YLexi/YL/Курсач.docx

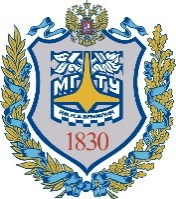
[picture p1: figure]
Gerb-BMSTU_01

| Министерство науки и высшего образования Российской Федерации Федеральное государственное бюджетное образовательное учреждение высшего образования «Московский государственный технический университет имени Н.Э. Баумана (национальный исследовательский университет)» (МГТУ им. Н.Э. Баумана)

ФАКУЛЬТЕТ _________РЛ__________________________________________________________

КАФЕДРА ___________РЛ-1___________________________________________________________

РАСЧЕТНО-ПОЯСНИТЕЛЬНАЯ ЗАПИСКА

К КУРСОВОМУ ПРОЕКТУ

НА ТЕМУ:

Зеркальная антенна для абонентского терминала системы спутниковой связи ________________________________ _______________________________________________

_______________________________________________

_______________________________________________

_______________________________________________

_______________________________________________

_______________________________________________

Студент РЛ1-61_________ _________________ Саломатин А.Д.______

(Группа) (Подпись, дата) (И.О.Фамилия)

Руководитель курсового проекта _________________ __В.А. Вечтомов_____

(Подпись, дата) (И.О.Фамилия)

Консультант _________________ ____________________

(Подпись, дата) (И.О.Фамилия)

2021 г.

Министерство науки и высшего образования Российской Федерации

Федеральное государственное бюджетное образовательное учреждение

высшего образования

«Московский государственный технический университет имени Н.Э. Баумана

(национальный исследовательский университет)»

(МГТУ им. Н.Э. Баумана)

УТВЕРЖДАЮ

Заведующий кафедрой __________

(Индекс)

______________ _______________

(И.О.Фамилия)

« _____ » ____________ 20 ____ г.

ЗАДАНИЕ

на выполнение курсового проекта

по дисциплине ____Устройства СВЧ и антенны____________________________________

Студент группы _РЛ1-61_________

______________________Саломатин Алексей Дмитриевич___________________________

(Фамилия, имя, отчество)

Тема курсового проекта:

Зеркальная антенна для абонентского терминала системы спутниковой связи

Направленность КП (учебный, исследовательский, практический, производственный, др.)

________________________________________________________________________________

Источник тематики (кафедра, предприятие, НИР) _____________________________________

График выполнения проекта: 25% к ___ нед., 50% к ___ нед., 75% к __ нед., 100% к ___ нед.

Задание: Разработать на уровне технического предложения приемо-передающую антенну типа Кассегрена или АДЭ приема для системы спутниковой связи (земная станция или абонентский терминал). Антенна должна удовлетворять следующим основным требованиям:

- рабочая частота на прием: 14,05…14,75 ГГц;
- коэффициент усиления не менее 48,5 дБ;
- поляризация принимаемых сигналов – на прием и передачу линейные, ортогональные;
- уровень боковых лепестков не выше -22 дБ.
- Рабочая частота на передачу: 11,25…11,95 ГГц

Оформление курсового проекта:

Расчетно-пояснительная записка на _____ листах формата А4.

Перечень графического (иллюстративного) материала (чертежи, плакаты, слайды и т.п.)

_______________________________________________________________________________

_______________________________________________________________________________

_______________________________________________________________________________

_______________________________________________________________________________

Дата выдачи задания « 24 » февраля 2021 г.

Руководитель курсового проекта _________________ В.А. Вечтомов_____

(Подпись, дата) (И.О.Фамилия)

Студент _________________ _А.Д. Саломатин_____

(Подпись, дата) (И.О.Фамилия)

Примечание: Задание оформляется в двух экземплярах: один выдается студенту, второй хранится на кафедре.

СОКРАЩЕНИЯ ТЕРМИНОВ, АББРЕВИАТУРЫ

КУ – коэффициент усиления

ТЗ – техническое задание

ДН – диаграмма направленности

КИП - коэффициент использования площади раскрыва антенны

КНД-коэффициент направленного действия

КПД - коэффициент полезного действия

УБЛ – уровень боковых лепестков

# Расчет геометрии антенны

Антенны типа Кассегрена относятся к классу двухзеркальных антенн.

Тогда:

Рабочую частоту примем равной середине диапазона, заданного в условии:

f=(14,75+14,05)/2=14,4 ГГц

Рабочая длинна волны:

λ=c/f=(3∙10^8)/(14,4∙10^9)≈20,83 мм,

где с-скорость света в вакууме.

Для нашей антенны справедливо следующее [1]:

G=9,96+20lg((D_0)/λ)+⁡k_(исп)

где G - коэффициент усиления (КУ) (по заданию равен 48,5 дБ)

D0 - диаметр большого зеркала

kисп – коэффициент использования поверхности раскрыва, примем его за -3 дБ

В итоге получим следующее:

D_0 =λ∙10^((G-9.96-k_(исп))/20) ≈1,246 м

Так как величина диаметра должна быть стандартизованной, то:

D_0 =1,3 м=1300 мм

Проверим выполнение условий ТЗ для этого диаметра, коэффициент усиления:

9,96+20lg(1300/(20,83))-3≈44.669 дБ

Данное значение очень близко к граничному и при погрешности измерительных приборов в 0.5 дБ КУ не будет удовлетворять заданному в ТЗ, поэтому увеличим диаметр большого зеркала до 1700 мм, тогда КУ:

9,96+20lg(1700/(20,83))-3≈45.195 дБ

Получившийся КУ превышает требуемый на 0.695 дБ, что гарантирует выполнение требований ТЗ. Таким образом:

D_0 =1,7 м=1700 мм

Так как гиперболоид софокусен параболоиду, мы можем получить остальные параметры кривых обоих зеркал. При этом нам необходимо дополнительно задать такие параметры как:

Предельный угол раствора параболы: φ_0 =80°

Угол облучения источником краев малого зеркала: φ_2 =8°

Для схемы Кассегрена справедливы следующие соотношения (f- фокусное расстояние гиперболы, F- фокусное расстояние параболы)

Эксцентриситет гиперболы: e=(sin((φ_0 +φ_2)/2))/(sin((φ_0 -φ_2)/2))≈1.182

Диаметр малого зеркала: d_0 =D_0 ((e-1))/((e+1))∙ctg((φ_0)/2)≈0,169 м=168,836 мм

Фокусное расстояние большого зеркала F=((e+1)∙d_0)/(4∙(e-1))≈0,506 м=506,495 мм

f=(d_0 ∙cos((φ_0 +φ_2)/2))/(4sin((φ_0)/2)∙cos((φ_2)/2))≈0,047351 м=47,351 мм

Расстояние до эквивалентного зеркала:

F_э =F∙(e+1)/(e-1)=6,078 м

Расчет волновода

Так как в задании указан диапазон частот 14,05…14,75 ГГц, то по ГОСТ Р 55774-2013 подходящее сечение прямоугольного волновода составляет 17,00 х 8,00 мм. Проверим, выполняются ли условия распространения для волны H10:

a<λ<2a

17 мм<20,83 мм<34 мм (верно)

2b<λ<2a

16 мм<20,83 мм<34 мм (верно)

Толщина стенок 1.4мм. Таким образом, сечение волновода 17,00 х 8,00 мм подходит для конструкции антенны.

Определение размеров раскрыва рупора

Для облучения будем использовать пирамидальный рупор. Важным условием при выборе рупора является тот факт, что на краях эквивалентного зеркала значение ДН должно отличаться от максимального на -10дБ. Таким образом, мы знаем значение ДН рупора на уровне -10дБ, оно равна φ_2 =8° (угол облучения краев эквивалентного зеркала). Диаграмма направленности рупора в Е-плоскости [2]:

F_E (θ)=(1+cosθ)/2∙(sinu_y)/(u_y)

Диаграмма направленности рупора в Н-плоскости:

F_H (θ)=(π/2)^2 (1+cosθ)/2∙(sinu_x)/((π/2)^2 -u_x)

где u_x и u_y – обобщённые угловые координаты, А, В - размеры рупора:

u_x =(πA)/λsinθ

u_y =(πB)/λsinθ

На краях эквивалентного зеркала должно выполняться следующее условия:

20log_10 ((1+cosφ_2)/2∙(sin(πB)/λsinφ_2)/((πB)/λsinφ_2))=-10

20log_10 ((π/2)^2 (1+cosφ_2)/2∙(sin(πA)/λsinφ_2)/((π/2)^2 -((πA)/λsinφ_2 )^2))=-10

Откуда:

B≈110 мм , А≈152 мм

Длину рупора возьмем равной:

L≈100 мм

Угол раскрыва в Е-плоскости:

α=arctg⁡((A/2-a/2)/L)≈34,206°

Величина фазового набега:

360/λ∙(L/(cos(α))-L)-360≈1,724°

Величина фазового набега меньше 45 градусов

Теперь можем построить ДН рупора в Е-плоскости (рисунок 1):

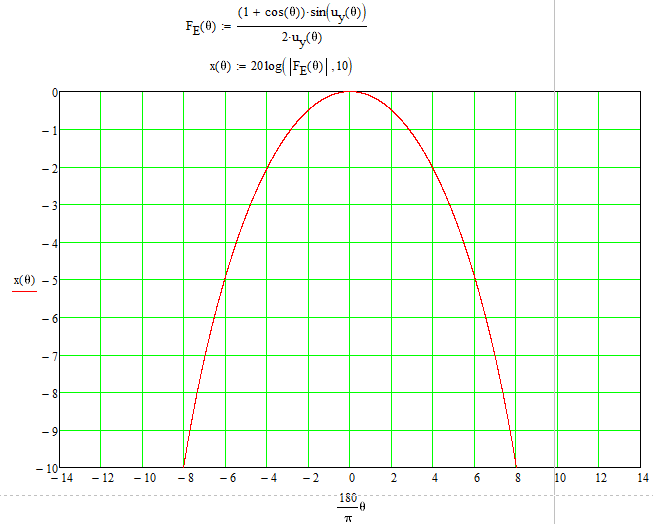
[picture p2: figure]

Рисунок 1

Уровню -10дБ соответствует угол, равный φ_2 =8° . ДН рупора в Н-плоскости имеет такую же форму и значению -10дБ также соответствуют углы в 8 и -8 градусов.

Расчет ДН антенны

С помощью радиуса эквивалентного зеркала (0.8м) и расстояния до него (6.078м) можем рассчитать ДН антенны с помощью подбора функции распределения амплитуд (Рисунок 2):

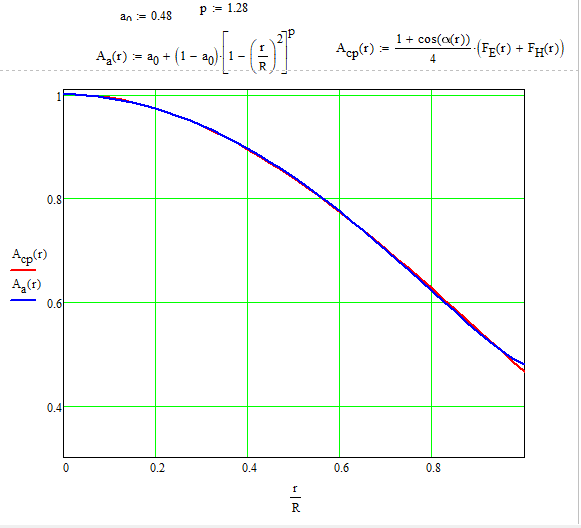
[picture p3: figure]

Рисунок 2

Итоговая ДН антенны построена с помощью функций Бесселя (Рисунок 3):

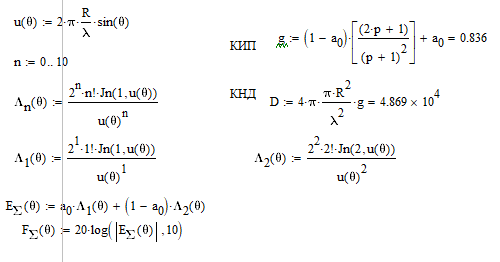
[picture p4: figure]

Рисунок 3

Она имеет следующий вид (Рисунок 4):

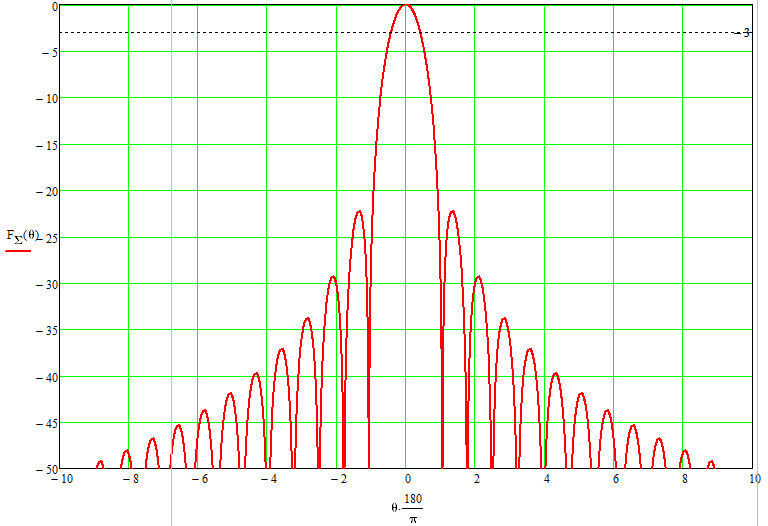
[picture p5: figure]

Рисунок 4

С помощью параметров аппроксимации рассчитаем КИП, КНД, КПД:

ν=(1-a_0 )∙(2p+1)/((p+1)^2)+a_0 =0,836

D=4π(πR^2)/(λ^2)∙ν=4,869∙10^4

Ширина главного лепестка по уровню – 3 дБ:

θ_0.5 =0,848°

Уровень боковых лепестков:

УБЛ=-22,282 дБ

УБЛ не превышает значения -22 дБ, что удовлетворяет требованиям ТЗ.

Описание конструкции волноводного фланца

По ГОСТ 13317-89 (таблица 6, чертеж 31) для прямоугольного волновода сечением 17,00 х 8,00 мм и толщиной стенок 1.4 мм подбираем фланец. Эскиз фланца, построенный в программе Компас-3Д, показан на рисунке 4:

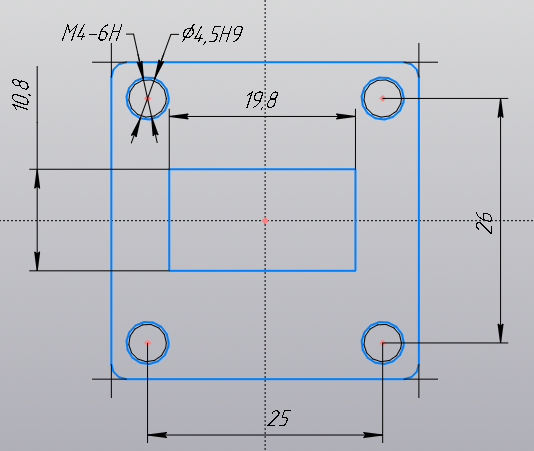
[picture p6: figure]

Рисунок 4

Литературные источники

1) «Антенны УКВ» Под ред. Г.З. Айзенберга. В 2-х ч. Ч.2.М., «Связь», 1977. с.20
2) «Исследование характеристик устройств СВЧ и антенн» В.Л. Хандамиров и др.-Москва : Издательство МГТУ им. Н.Э. Баумана, 2018,с.29.
3) «Антенны УКВ» Под ред. Г.З. Айзенберга. В 2-х ч. Ч.1.М., «Связь», 1977, с.153
