YLexi/YL/РПЗ.docx

Gerb-BMSTU_01

| Министерство науки и высшего образования Российской Федерации Федеральное государственное бюджетное образовательное учреждение высшего образования «Московский государственный технический университет имени Н.Э. Баумана (национальный исследовательский университет)» (МГТУ им. Н.Э. Баумана)

ФАКУЛЬТЕТ _________РЛ__________________________________________________________

КАФЕДРА ___________РЛ-1___________________________________________________________

РАСЧЕТНО-ПОЯСНИТЕЛЬНАЯ ЗАПИСКА

К КУРСОВОМУ ПРОЕКТУ

НА ТЕМУ:

Зеркальная антенна для абонентского терминала системы спутниковой связи___________________________________________

_______________________________________________

_______________________________________________

_______________________________________________

_______________________________________________

_______________________________________________

Студент РЛ1-61_________ _________________ __С.А. Чекановский_

(Группа) (Подпись, дата) (И.О.Фамилия)

Руководитель курсового проекта _________________ __В.А. Вечтомов_____

(Подпись, дата) (И.О.Фамилия)

Консультант _________________ ____________________

(Подпись, дата) (И.О.Фамилия)

2021 г.

Министерство науки и высшего образования Российской Федерации

Федеральное государственное бюджетное образовательное учреждение

высшего образования

«Московский государственный технический университет имени Н.Э. Баумана

(национальный исследовательский университет)»

(МГТУ им. Н.Э. Баумана)

УТВЕРЖДАЮ

Заведующий кафедрой __________

(Индекс)

______________ _______________

(И.О.Фамилия)

« _____ » ____________ 20 ____ г.

ЗАДАНИЕ

на выполнение курсового проекта

по дисциплине ____Устройства СВЧ и антенны____________________________________

Студент группы _РЛ1-61_________

__Чекановский Сергей Александрович____________________________________________

(Фамилия, имя, отчество)

Тема курсового проекта:

Зеркальная антенна для абонентского терминала системы спутниковой связи

Направленность КП (учебный, исследовательский, практический, производственный, др.)

________________________________________________________________________________

Источник тематики (кафедра, предприятие, НИР) _____________________________________

График выполнения проекта: 25% к ___ нед., 50% к ___ нед., 75% к __ нед., 100% к ___ нед.

Задание: Разработать на уровне технического предложения приемо-передающую антенну типа Кассегрена или АДЭ приема для системы спутниковой связи (земная станция или абонентский терминал). Антенна должна удовлетворять следующим основным требованиям:

- рабочая частота на прием: 7,9…8,4 ГГц;
- коэффициент усиления не менее 39 дБ;
- поляризация принимаемых сигналов – на прием и передачу линейные, ортогональные;
- уровень боковых лепестков не выше -22 дБ.
- Рабочая частота на передачу: 7,1…7,7 ГГц

Оформление курсового проекта:

Расчетно-пояснительная записка на _____ листах формата А4.

Перечень графического (иллюстративного) материала (чертежи, плакаты, слайды и т.п.)

_______________________________________________________________________________

_______________________________________________________________________________

_______________________________________________________________________________

_______________________________________________________________________________

Дата выдачи задания « 24 » февраля 2021 г.

Руководитель курсового проекта _________________ В.А. Вечтомов_____

(Подпись, дата) (И.О.Фамилия)

Студент _________________ _С.А. Чекановский_

(Подпись, дата) (И.О.Фамилия)

Примечание: Задание оформляется в двух экземплярах: один выдается студенту, второй хранится на кафедре.

# СОДЕРЖАНИЕ

ПЕРЕЧЕНЬ СОКРАЩЕНИЙ И ОБОЗНАЧЕНИЙ………………………….4

1 Расчёт геометрии антенны………………………………………………….5

2 Расчёт характеристик излучения антенны………………………………...9

2.1 Расчёт облучателя…………………………………………………….9

2.2 Диаграмма направленности антенны……………………………....12

3 Моделирование и конструирование антенны……………………………16

3.1 Большое зеркало……………………………………………………..16

3.2 Фланец для большого зеркала………………………………………17

3.3 Волноводный фланец………………………………………………..18

3.4 Рупор………………………………………………………………….19

3.5 Малое зеркало………………………………………………………..20

3.6 Штанга………………………………………………………………..22

3.7 Крепление штанги…………………………………………………...22

3.8 Проверка коэффициента усиления антенны……………………….23

СПИСОК ИСПОЛЬЗОВАННЫХ ИСТОЧНИКОВ………………………..26

ПЕРЕЧЕНЬ СОКРАЩЕНИЙ И ОБОЗНАЧЕНИЙ

В настоящем отчете о НИР применяют следующие сокращения и обозначения:

ДН – диаграмма направленности

КИП – коэффициент использования поверхности

КНД – коэффициент направленного действия

КПД – коэффициент полезного действия

КУ – коэффициент усиления

ТЗ – техническое задание

УБЛ – уровень боковых лепестков

1 Расчёт геометрии антенны

Схема рассматриваемой двухзеркальной антенны Кассегрена приведена на рисунке 1.

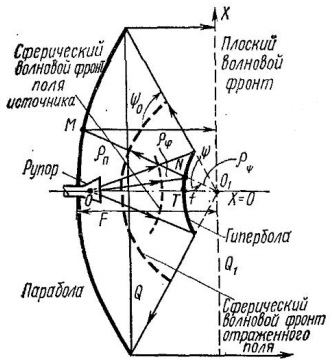
[picture p7: figure]

Рисунок 1 – Схема Кассегрена

Основное зеркало является симметрично усечённым параболоидом вращения с фокусным расстоянием F, вспомогательное зеркало – симметрично усечённым гиперболоидом вращения с фокусным расстоянием f. Гиперболоид софокусен параболоиду в точке O_1 , второй его фокус расположен в точке О.

Перейдём к расчёту геометрии зеркал. Запишем выражение для нахождения коэффициента усиления двухзеркальной антенны:

G=9,96+20lg((D_0)/λ)+10lgk_(исп) ,

где D_0 - диаметр главного зеркала, λ - длина волны, k_(исп) - коэффициент использования поверхности (КИП) двухзеркальной антенны.

Величину k_(исп) примем равной 0,5, подставим значение коэффициента усиления G и найдём отношение D_0 /λ :

9,96+20lg((D_0)/λ)-3=39⇒(D_0)/λ≈43,467.

Для определения рабочей длины волны зададим рабочую частоту f, равную середине заданного в условии диапазона приёма:

f_(пр) =(8,4+7,9)/2=8,15 ГГц.

Тогда

λ=c/f=(3*10^8)/(8,15*10^9)≈0,037 м.

Отсюда

D_0 ≈1,472 м.

Выберем ближайшее значение из стандартного ряда: D_0 =1,600 м.

Определим диаметр вспомогательного зеркала d_0 . Примем

d_0 =8λ=0,294 м.

Зададим ещё два базовых параметра:

- угол раствора образующей параболы: ψ_0 = 96 ⁰;

- угол облучения источником краёв малого зеркала: φ_2 = 25,58⁰.

Теперь на основании этих четырёх параметров можем определить основные геометрические характеристики антенны:

- эксцентриситет гиперболы: e = (sin((ψ_0 +φ_2)/2))/(sin((ψ_0 -φ_2)/2))=(sin((85^⁰ +18^⁰)/2))/(sin((85^⁰ -18^⁰)/2)) ≈ 1,514;

- фокусное расстояние параболического зеркала:

F=0,25D_0 ctg((ψ_0)/2)≈0,36 м;

- фокусное расстояние гиперболического зеркала:

f = (d_0)/4(cos((ψ_0 +φ_2)/2))/(sin((ψ_0)/2)*cos((φ_2)/2)) ≈ 0,05 м;

- расстояние между фокусами гиперболоида:

2C = (d_0)/2(sin(ψ_0 +φ_2 ))/(sin(ψ_0 )*sin(φ_2 )) = 0,292 м;

- расстояние между вершинами гиперболоида:

2a = (d_0)/2(1/(sin(φ_2 ))-1/(sin(ψ_0 ))) ≈ 0,193 м;

- угол облучения источником краёв затенённой области раскрыва:

φ_1 = 2arctg((e-1)/(e+1))^2 ≈ 2,771⁰.

Проведём проверку полученных значений, для чего оценим истинность следующих равенств:

(4F)/(d_0)=(e+1)/(e-1);

(d_0)/(D_0)=(e-1)/(e+1)ctg((ψ_0)/2);

2C=2a+2f;

e=C/a≥1.

Расчёты, произведённые в программе Mathcad 15, подтверждают их истинность (рисунок 2).

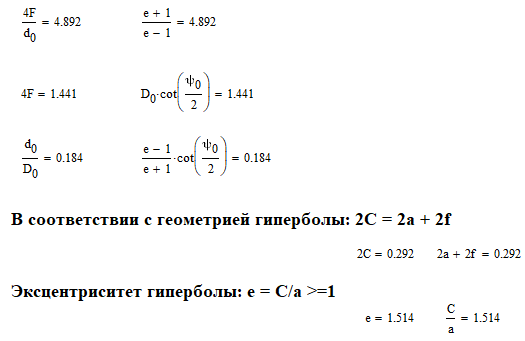
[picture p8: figure]

Рисунок 2 – Проверка расчёта основных геометрических параметров антенны

2 Расчёт диаграммы направленности антенны

2.1 Расчёт облучателя

Для расчёта ДН однозеркальной системы нам необходимо сначала получить ДН облучателя. Выберем в качестве облучателя пирамидальный рупор с прямоугольным раскрывом (рисунок 3).

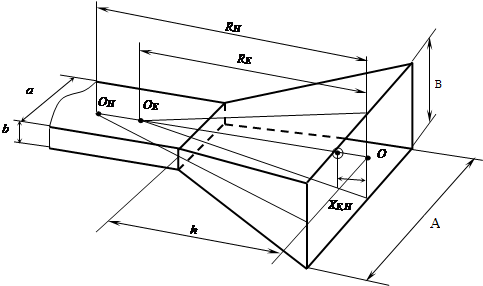
[picture p9: figure]

Рисунок 3 – Геометрия пирамидального рупора

Определим его геометрические размеры, пользуясь выражениями для ДН рупора в двух главных плоскостях симметрии: Е-плоскости и Н-плоскости:

F_E (θ)=(1+cosθ)/2∙(sinu_y)/(u_y);

F_H (θ)=0,15(π)^2 ∙(0,67+cosθ)∙(sinu_x)/((π/2)^2 -u_x),

где u_x и u_y – обобщённые угловые координаты:

u_x =(πA)/λsinθ;

u_y =(πB)/λsin(0,8θ).

Для эффективной работы антенны уровень поля на краях малого зеркала должен равняться приблизительно –10 дБ. Понимая под углом θ угол облучения источником краёв малого зеркала: φ_2 = 25.58⁰, вычислим в программе Mathcad геометрические размеры рупора (рисунок 4).

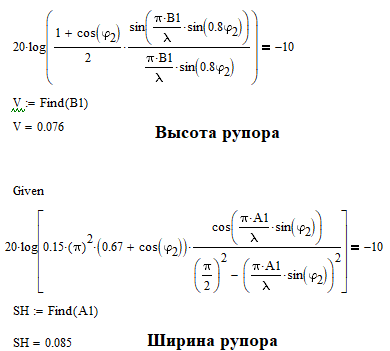
[picture p10: figure]

Рис. 4 – Вычисление размеров апертуры облучателя в программе Mathcad

Таким образом, А = 0,060 м (Н-плоскость), В = 0,088 м (Е-плоскость).

Проверим правильность полученных размеров раскрыва: построим ДН рупора в плоскостях Е и Н (рисунок 5).

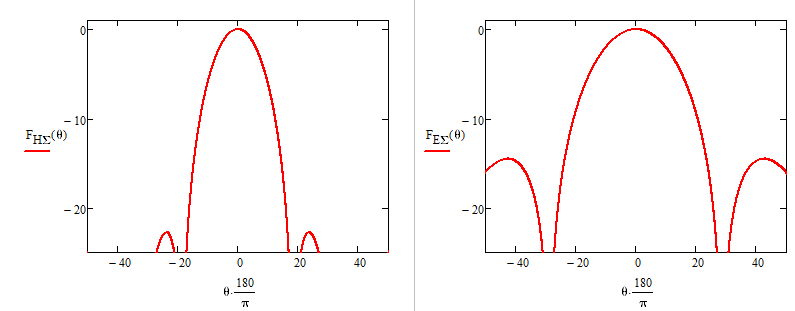
[picture p11: figure]

Рисунок 5 - ДН рупора в плоскостях Е и Н

Как видно из рисунка, значения диаграмм в -10 дБ действительно соответствуют углу φ_2 .

Рассчитаем длину рупора в плоскостях Е и Н (см. рисунок 4). Расстояние в плоскости Е:

R_E =(B^2)/(2λ)=0.079 м;

Расстояние R_H получим из уравнения «стыковки рупора с волноводом»:

R_H (1-a/A)=R_E (1-b/B)⇒R_H =(R_E (1-b/B))/((1-a/A))=0.099 м.

Длина самого рупора (расстояние от центра раскрыва до горловины рупора, одинаковое в плоскостях Е и Н) h можно определить из следующих соотношений:

A/a=(R_H)/(R_H -h)⇒h=0.065 м;

B/b=(R_E)/(R_E -h)⇒h=0.065 м.

Рассчитаем углы раскрыва рупора в обеих плоскостях:

- в плоскости Н:

tgα=(A/2)/(R_H)⇒α=arctg(A/(2R_H))≈23,2^0 ;

- в плоскости E:

tgβ=(B/2)/(R_E)⇒β=arctg(B/(2R_E))≈25,7^0 .

Волна, излучаемая рупором, имеет сферический фронт. Если отклонение фаз на краях рупора не превышает 45⁰, излучающую поверхность считается синфазной. Т.к. углы раскрыва рупора в обеих плоскостях меньше 45⁰, наш рупор «длинный» - фазовыми искажениями можно пренебречь.

2.2 Диаграмма направленности антенны

В приближении геометрической оптики двухзеркальная антенна может быть сведена к эквивалентной ей по распределению поля в раскрыве однозеркальной антенне того же диаметра (рисунок 6).

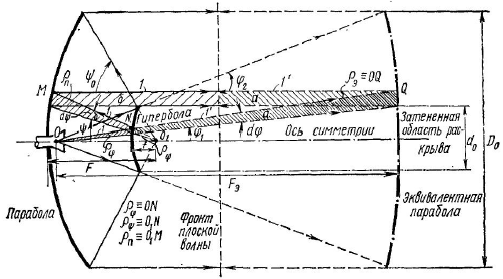
[picture p12: figure]

Рисунок 6 – Эквивалентная схема однозеркальной антенны

Определим фокусное расстояние нового эквивалентного зеркала:

F_Э =F((e+1)/(e-1))≈1,762 м.

Радиус эквивалентного параболоида равен радиусу исходного:

R=(D_0)/2=0,8 м.

Вновь запишем выражения ДН облучателя по приближённым формулам для рупора с малым раскрывом:

- в плоскости вектора электрического поля (плоскость Е):

F_E (α)≈1/2(1+cosα)(sin[(πb)/λsin(0,8α)])/((πb)/λsin(0,8α));

- в плоскости вектора магнитного поля (плоскость H):

F_H (α)≈0,15π^2 (0,67+cosα)(cos((πa)/λsinα))/((π/2)^2 -((πa)/λsinα)^2).

Задаваясь координатами точек на раскрыве зеркала, определим значения α по формуле:

α=arctg[(r/R)/(((F_Э)/R-(r/R)^2 R/(4F)))].

Найдём усреднённое распределение амплитуд поля в раскрыве:

A(r)=(1+cosα)/4[F_E (α)+F_H (α)].

Функция, аппроксимирующая распределение амплитуд:

A^(') (r)=a_0 +(1-a_0 )[1-(r/R)^2 ]^p .

Обеспечим её наименьшее отклонение от усреднённого распределения подбором показателя p и постоянной составляющей a_0 : p = 1,4, a_0 = 0,3.

Построим теперь на одном графике обе функции распределения: усреднённому соответствует красная кривая, аппроксимирующему – синяя (рисунок 7).

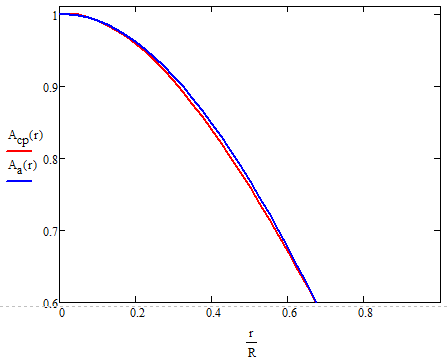
[picture p13: figure]

Рисунок 7 – Усреднённое распределение поля в раскрыве и его аппроксимация

Перейдём непосредственно к расчёту диаграммы направленности (ДН) антенны Кассегрена. Т.к. ось зеркала проходит через центр раскрыва рупора облучателя, запишем:

E_Σ (θ)=a_0 Λ_1 (u)+(1-a_0 )Λ_(p+1) (u),

где Λ_n (u) - лямбда-функция n-го порядка, связанная с функцией Бесселя;

u - обобщённая угловая координата: u=2πR/λsinθ;

θ – угол между осью антенны и направлением в точку наблюдения.

Лямбда-функции вычисляются следующим образом:

Λ_n (u)=(2^n ∙n!∙J_n (u))/(u^n),

где J_n (u) – функция Бесселя 1-го рода n-го порядка.

Подставляя значения для a_0 и p, построим ДН антенны в программе Mathcad (рис. 8).

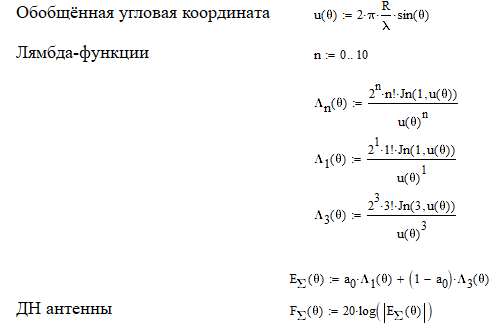
[picture p14: figure]

Рисунок 8 – расчёт ДН антенны в Mathcad 15

Её график имеет вид, представленный на рисунке 9.

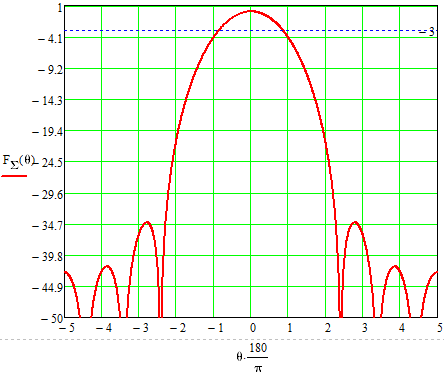
[picture p15: figure]

Рисунок 9 – ДН антенны Кассегрена

Ширина ДН по уровню половинной мощности: 2θ_(0,5p) ≈2,1^0 .

УБЛ: -24,6 дБ.

Согласно ТЗ УБЛ не должен быть выше -34.5 дБ, и данное требование выполняется.

3 Моделирование и конструирование антенны

Создание трёхмерной модели антенны на основе полученных данным будем проводить в программе SolidWorks 2019. Общий вид антенны представлен на рисунке 10.

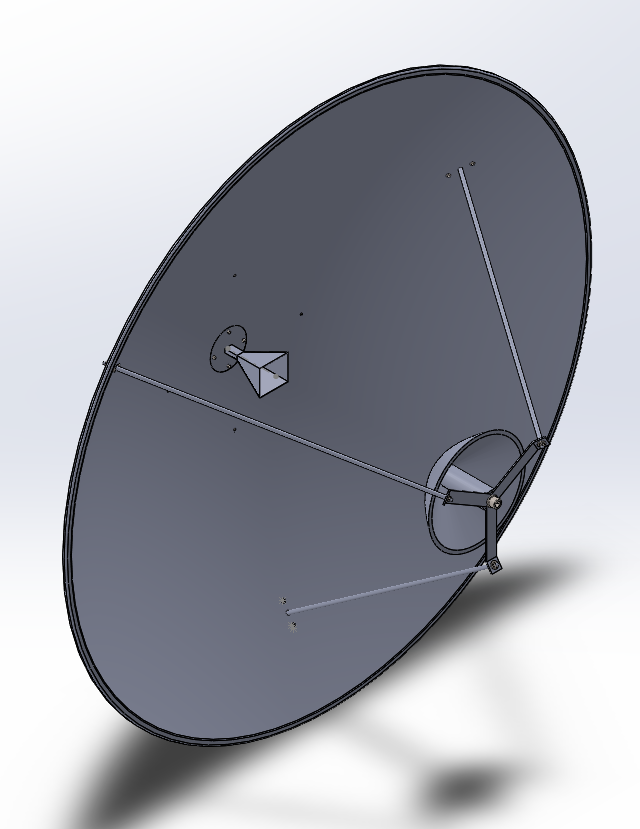
[picture p16: figure]
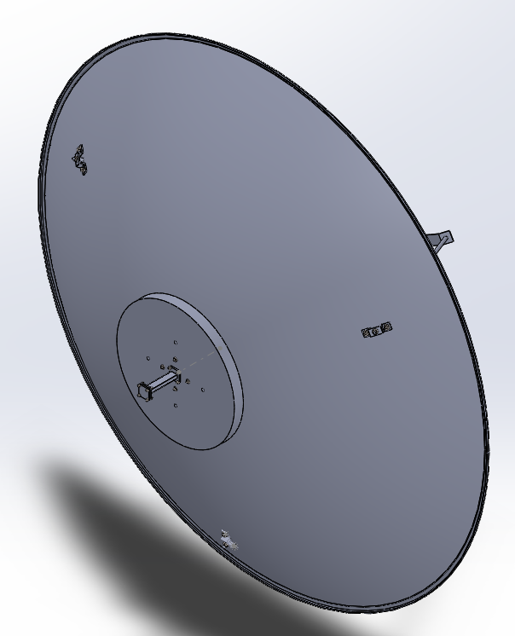
[picture p17: figure]

Рисунок 10 – Общий вид антенны Кассегрена

Габаритные размеры конструкции: 952 × 1600 × 1600 мм.

  3.1 Большое зеркало

Главное зеркало представляет собой параболоид вращения с фокусным расстоянием 0,36 м и диаметром D_0 =1,600 м. Толщина изделия – 2 мм. Его конструкция изделия приведена на рисунке 11.

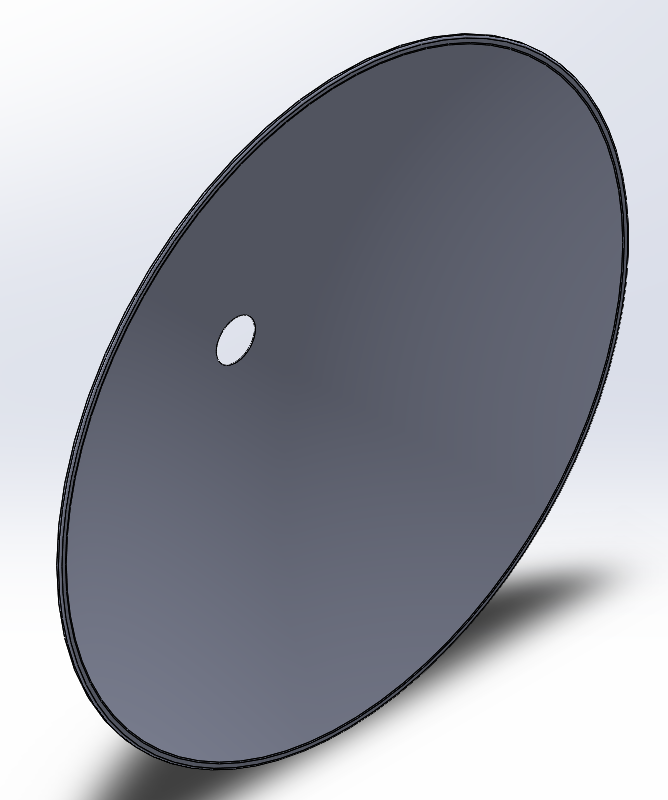
[picture p18: figure]

Рисунок 11 – Большое зеркало

В качестве материала используется алюминиевый сплав АД31 (1310) по ГОСТ 4784-97. Профиль зеркала изготавливается штамповкой, после чего в нём просверливаются необходимые отверстия для креплений.

  3.2 Фланец для большого зеркала

Деталь служит для крепления параболического зеркала. Заготовка представляет собой цилиндр высотой 32 мм и диаметром 420 мм, изготовленный из алюминиевого сплава АД31. Форма придается путем токарной обработки, затем высверливаются соответствующие отверстия:

- сквозное прямоугольное для волновода;

- со стороны зеркала 4 отверстия с резьбой М3 (ГОСТ 24705 – 2004) для крепления к зеркалу;

- с противоположной стороны 4 отверстия с резьбой М8 для закрепления самой антенны;

- 8 отверстий с резьбой М4 для крепления волноводных фланцев и рупора.

Внешний вид детали представлен на рисунке 12.

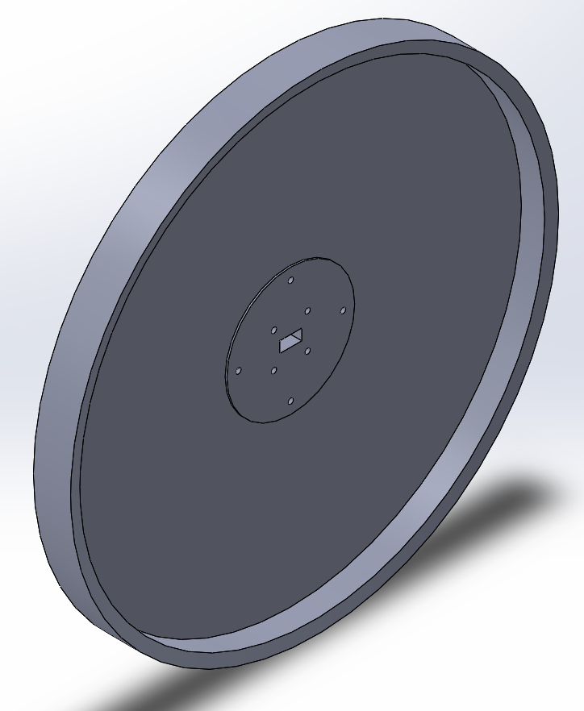
[picture p19: figure]
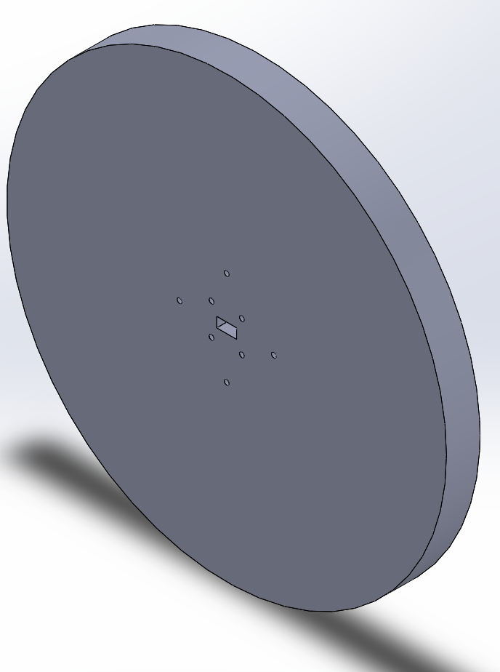
[picture p20: figure]

Рисунок 12 – Фланец для большого зеркала

  3.3 Волноводный фланец

Прямоугольному волноводу с поперечными размерами 19 × 9,5 мм согласно ГОСТ 13317-89 соответствует фланец показанный на рисунке 13.

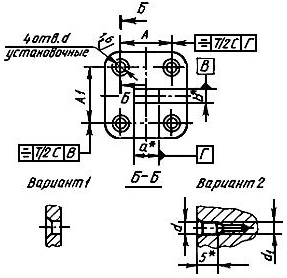
[picture p21: figure]

Рисунок 13 – Чертёж волноводного фланца

Размеры, представленные на чертеже:

- А_1 = (29 ∓ 0,05) мм;

- А_2 = (30 ∓ 0,05) мм;

- d = 4,5 мм;

- d_1 = М4;

- c = 0,05 мм.

Толщина фланца составляет 5 мм.

Соединение фланца с волноводом, фланцем для большого зеркала и крышкой волновода происходит через 4 резьбовые отверстия М4.

  3.4 Рупор

Изготавливается методом токарной обработки, заготовка – прямоугольный параллелепипед с основанием 77,5 × 86,5 мм и высотой 65 мм. Толщина стенок – 1,5 мм; материал изделия – сплав медно-цинковый (латунь) ЛЦ16К4 согласно ГОСТ 17711-93. Вид снаружи и в разрезе представлен на рисунке 14.

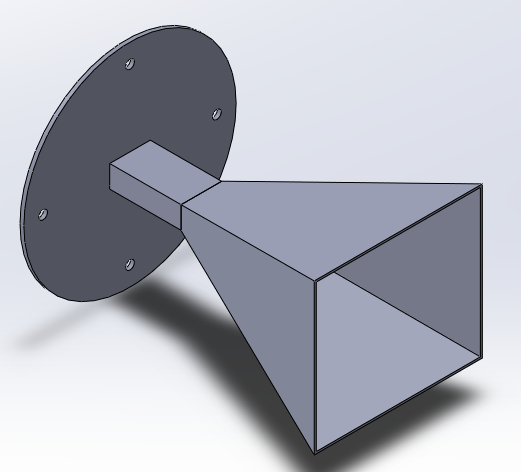
[picture p22: figure]
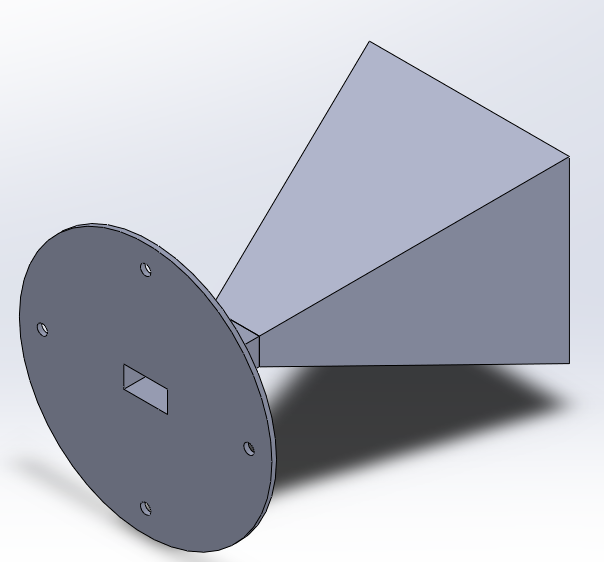
[picture p23: figure]

Рисунок 14 – Рупор с участком волновода

Волновод соединяется с волноводным фланцем пайкой; фланец с помощью резьбового соединения М4 крепится винтами к фланцу большого зеркала (рисунок 15).

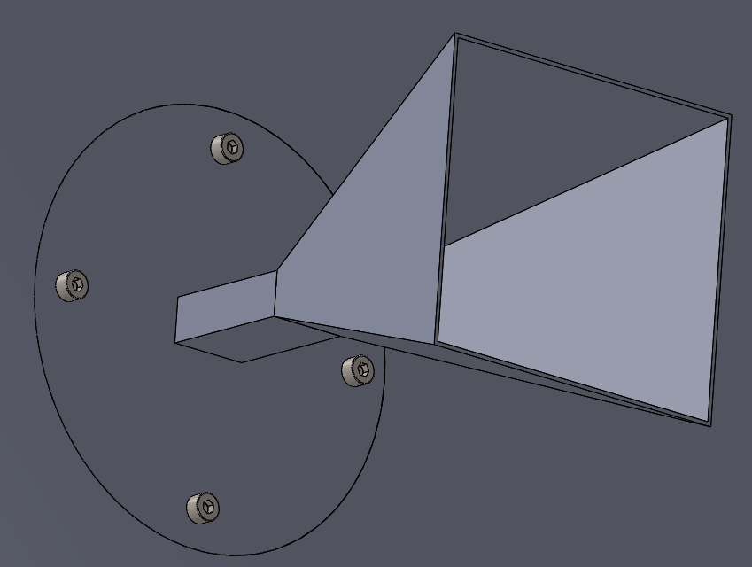
[picture p24: figure]

Рисунок 15 – Крепление облучателя к фланцу большого зеркала

К противоположной стороне фланца для большого зеркала аналогичным образом на винтах крепится волноводный фланец, к которому припаян участок волновода; этот участок вновь заканчивается припаянным фланцем, который соединяется с крышкой резьбовым соединением М4 (рисунок 16).

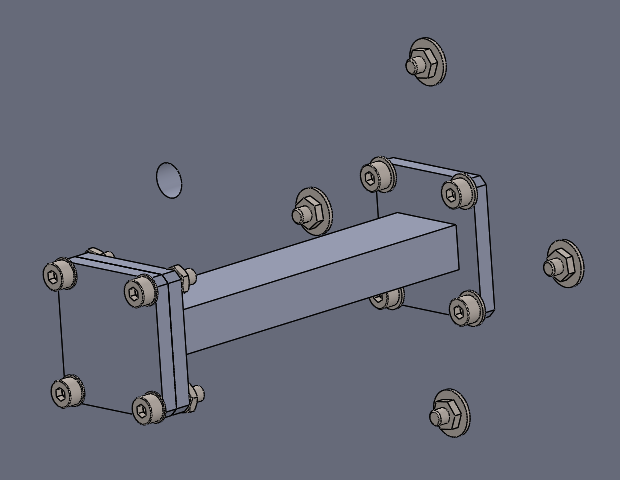
[picture p25: figure]

Рисунок 16 – Крепление волновода к зеркалу и крышке

  3.5 Малое зеркало

Малое зеркало представляет собой гиперболоид вращения диаметром 294 мм. Оно, как и главное зеркало, изготавливается из алюминиевого сплава АД31 по ГОСТ 4784-97. Из цилиндрической заготовки диаметром 294 мм и высотой 150 мм за счёт токарной обработки вытачивается нужный профиль (рисунок 17).

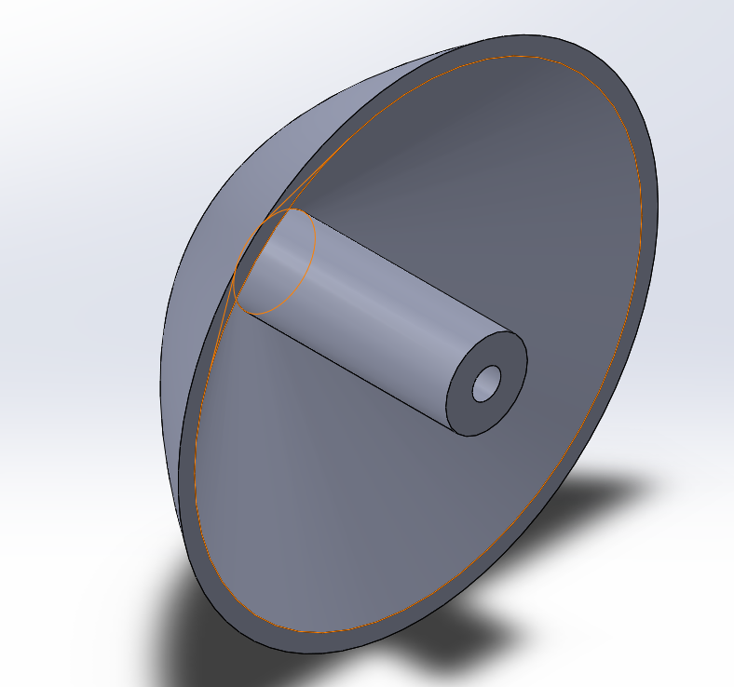
[picture p26: figure]

Рисунок 17 – Малое зеркало

В тыльной стороне высверливается отверстие для дальнейшего нарезания резьбы М18, через которое посредством болта и шайбы к детали присоединяется крепление малого зеркала (рисунок 18).

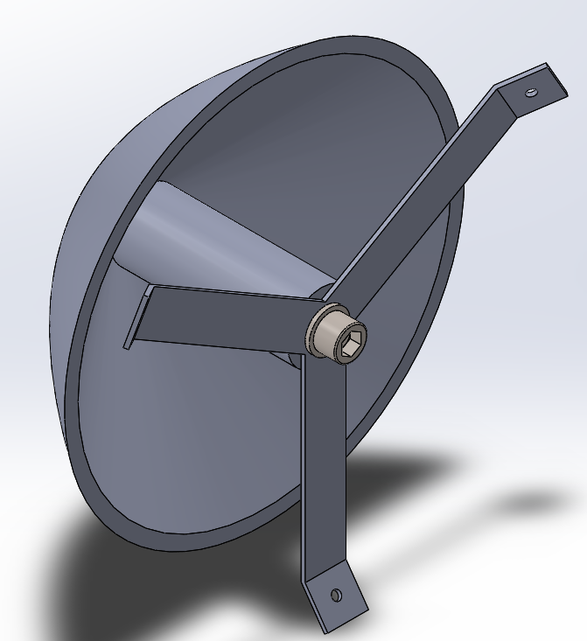
[picture p27: figure]

Рисунок 18 – Крепление малого зеркала

Деталь крепления имеет толщину 3 мм, и в ней вырезаются 3 отверстия М6 для крепления штанги.

  3.6 Штанга

Штанга изготавливается из цилиндрической алюминиевой заготовки 520 × 6 мм путём токарной обработки. С обоих её концов вытачиваются участки длиной в 5 мм с резьбой М6. Крепление штанги к конструкции малого зеркала приведено на рисунке 19.

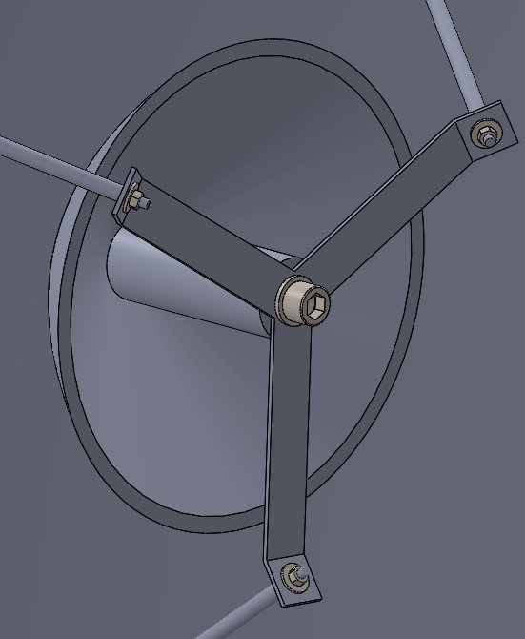
[picture p28: figure]

Рисунок 19 – Крепление штанги к малому зеркалу

  3.7 Крепление штанги

С противоположной стороны штанга крепится к большому зеркалу с помощью специальной скобы, в которой проделано отверстие М6. Скоба присоединяется к большому зеркалу при помощи сквозных отверстий М2 (рисунок 20).

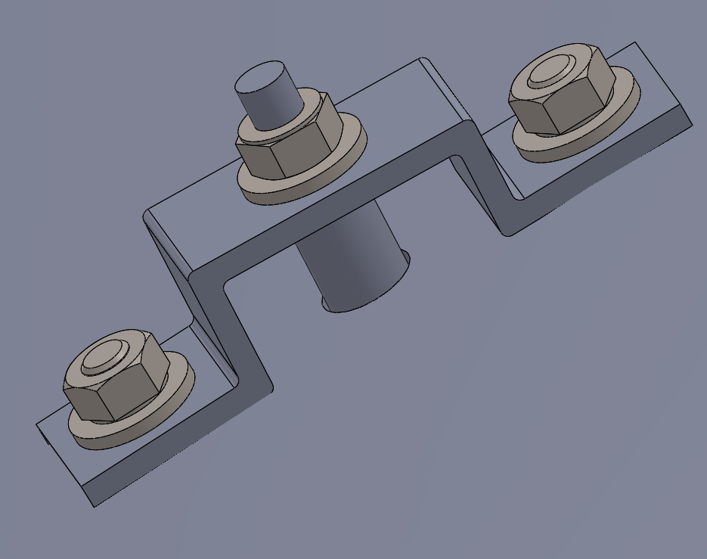
[picture p29: figure]

Рисунок 20 – Крепление штанги к большому зеркалу

3.8 Проверка КУ антенны

Из-за наличия отверстий, а также различных крепёжных элементов в раскрыве площадь излучающей поверхности уменьшилась – появилось затенение. Тогда площадь излучения может быть посчитана следующим образом:

S_н =S-S_(отв) -3∙S_(шт) -10∙S_ш -S_(мз) ,

где S= (πD_0 ^2)/4≈2 м^2 – исходная площадь большого зеркала;

S_(отв) - площадь затенения, создаваемая центральным отверстием в большом зеркале диаметром d = 110 мм: S_(отв) =(πd^2)/4≈0,01 м^2 ;

S_(шт) - площадь затенения, создаваемая штангой с поперечным сечением s= = 6 мм: S_(шт) =(πs^2)/4≈2,827∙10^(-5) м^2 ;

S_ш - площадь затенения, создаваемая шайбой М6 диаметром d_ш 12 мм:

S_ш =(πd_ш ^2)/4≈1,131∙10^(-4) м^2 ;

S_(мз) - площадь затенения, создаваемая малым зеркалом диаметром d_0 :

S_(мз) =(πd_0 ^2)/4≈0,07 м^2 .

Тогда S_н ≈1,919 м^2 . Следовательно, диаметр незатенённого зеркала:

D_(oн) =√((4∙S_н)/π)≈1,56 м.

Полученный нами диаметр почти совпадает с исходным.

Для расчёта D_0 значение k_(исп) мы приняли равным 0,5, теперь же определим КИП точно как произведение ряда сомножителей, каждый из которых учитывает влияние одного какого-либо фактора, а именно:

k_(исп) =k_a k_0 k_ф k_п k_д k_з k_н k_с k_т .

- k_a – апертурный КИП – учитывает потери на усиление вследствие неравномерности амплитудного распределения в плоскости раскрыва:

k_a =2ctg^2 ((φ_2)/2)(|∫_(φ_1)^(φ_2) F_0 (θ)∙tg(θ/2)dθ∙2π|^2)/(2π∙∫_0^π |F_0 (θ)|^2 sinθdθ∙2π),

где F_0 (θ) – нормированная ДН источника (для простоты – осесимметричная).

Тогда k_a ≈1,12.

- k_0 – коэффициент перехвата энергии источника малым зеркалом:

k_0 =(∫_(φ_1)^(φ_2) |F_0 (θ)|^2 sinθdθ∙2π)/(∫_0^π |F_0 (θ)|^2 sinθdθ∙2π)≈1,14;

- k_ф – учитывает потери усиления вследствие неравномерности фазового распределения в раскрыве: примем за 0,2 дБ;

- k_п – учитывает потери усиления вследствие перехода части излучённой энергии в кросс-поляризованную составляющую поля: примем за 0,2 дБ;

- k_д – учитывает потери усиления вследствие дифракционного рассеяния поля источника на кромках зеркал и на элементах их крепления: примем за 0,2 дБ;

- k_з – учитывает потери усиления вследствие затенения излучающего раскрыва конструкциями крепления вспомогательного зеркала: примем за 0,2 дБ;

- k_н – учитывает потери усиления вследствие неточности выполнения поверхностей основного и вспомогательного зеркал: примем за 0,2 дБ;

- k_с – учитывает потери усиления вследствие неточной установки в антенне рупора и малого зеркала как между собой, так и относительно большого зеркала примем за 0,1 дБ;

- k_т – учитывает потери усиления вследствие тепловых потерь в отражающих поверхностях и из-за наличия защитных лакокрасочных покрытий: примем за 0,1 дБ.

Перемножив значения коэффициентов, получим: k_(исп) ≈0,90.

Рассчитаем теперь КУ нашей антенны:

G_н =9,96+20lg((D_(oн))/λ)+10lgk_(исп) ≈39,606 дБ.

Полученное значение КУ также очень близко к заданному. Согласно ТЗ, оно не должно быть меньше 39 дБ – это условие выполняется.

СПИСОК ИСПОЛЬЗОВАННЫХ ИСТОЧНИКОВ

1. Айзенберг Г. З. и др. Антенны УКВ. Под ред. Г. З. Айзенберга. В 2 ч. Ч. 1. М., «Связь», 1977 – 384 с. с ил.
2. Айзенберг Г. З. и др. Антенны УКВ. Под ред. Г. З. Айзенберга. В 2 ч. Ч. 2. М., «Связь», 1977 – 288 с. с ил.
3. Исследование характеристик устройств СВЧ и антенн. Методические указания к выполнению лабораторных работ / [В. Л. Хандомиров и др.]. – Москва: Издательство МГТУ им. Н. Э. Баумана, 2018. – 74, [2] с.: ил.
