YLexi/YL/GmuAHXDPHOM.jpg

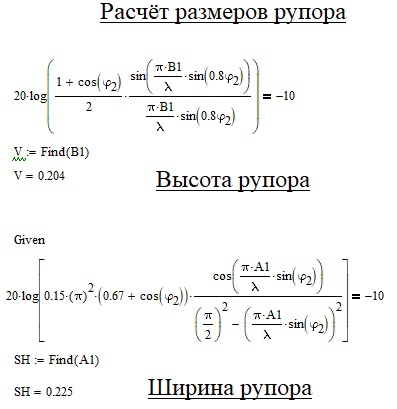
GmuAHXDPHOM.jpg
