YLexi/YL/КУРСАЧ2/Kursach (1)/Сборка малого зеркала.SLDASM

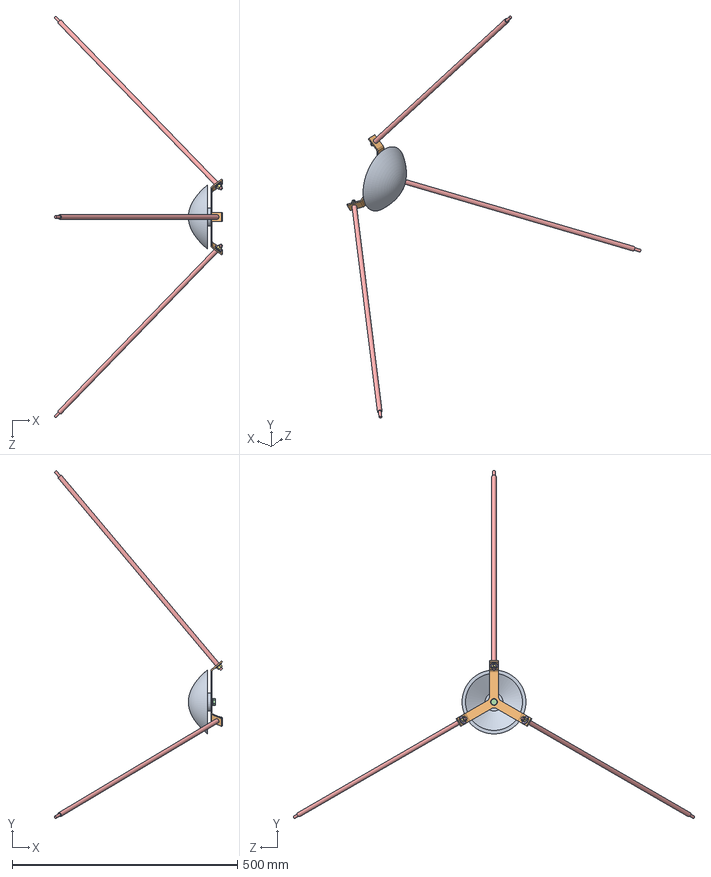
[picture p36: CAD file, 2021-09-20]
КУРСАЧ2/Kursach (1)/Сборка малого зеркала.SLDASM
374.2 x 773.3 x 892.0 mm
Малое зеркало
Крепление малого зеркала
plain washer clevis pin grade a_iso
hex bolt gradeb_iso
Шпильеп x 3
plain washer large grade ac_iso x 3
hex nut gradec_iso x 3
