YLexi/YL/Новая папка1/КУРСАЧ2/Solid — копия/сборка малого зеркала.SLDASM

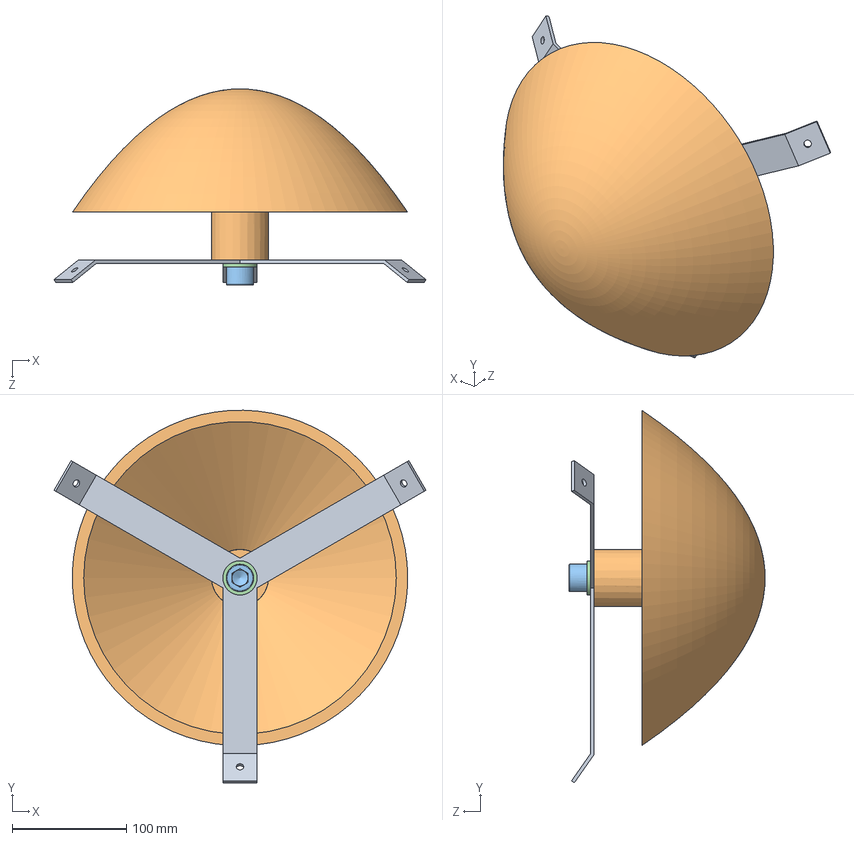
[picture p38: CAD file, 2021-09-20]
Новая папка1/КУРСАЧ2/Solid — копия/сборка малого зеркала.SLDASM
326.0 x 326.5 x 172.0 mm
креп м зеркала
М зеркало
socket head cap screw_iso
plain washer normal grade a_iso
