YLexi/YL/КУРСАЧ2/Solid — копия/СБОРКА АНТЕННЫ.SLDASM

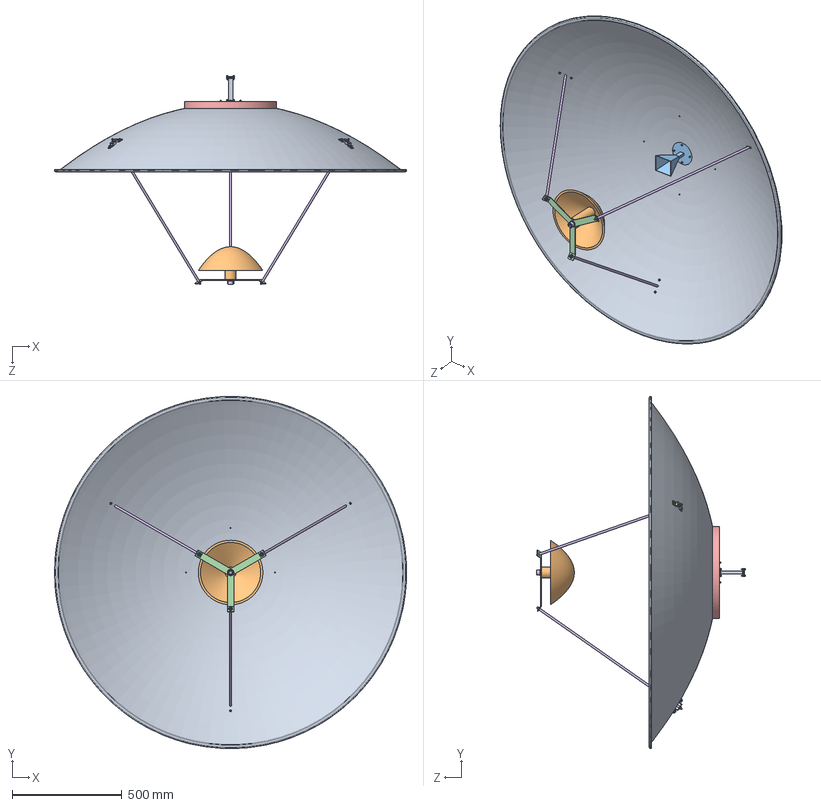
[picture p39: CAD file, 2021-09-20]
КУРСАЧ2/Solid — копия/СБОРКА АНТЕННЫ.SLDASM
1603.3 x 1603.6 x 952.6 mm
Главное зеркало
М зеркало
рупр
креп м зеркала
бол фланец
socket head cap screw_iso x 13
plain washer large grade ac_iso x 4
hex thin nut gradeb_iso x 4
Волнов0д
plain washer normal grade a_iso x 5
Заглyшка норм
plain washer small grade a_iso x 4
hex thin nut chamfered gradeab_iso x 4
Шпилька x 3
Крепление штанги x 3
flat washer regular_am x 3
hex nut style 1_am x 3
socket button head screw_iso x 10
plain washer 10673 type snl_iso x 9
hex nut style 1 gradeab_iso x 9
