YLexi/YL/Новая папка1/КУРСАЧ2/Kursach (1)/Антенна Кассегрена.SLDASM

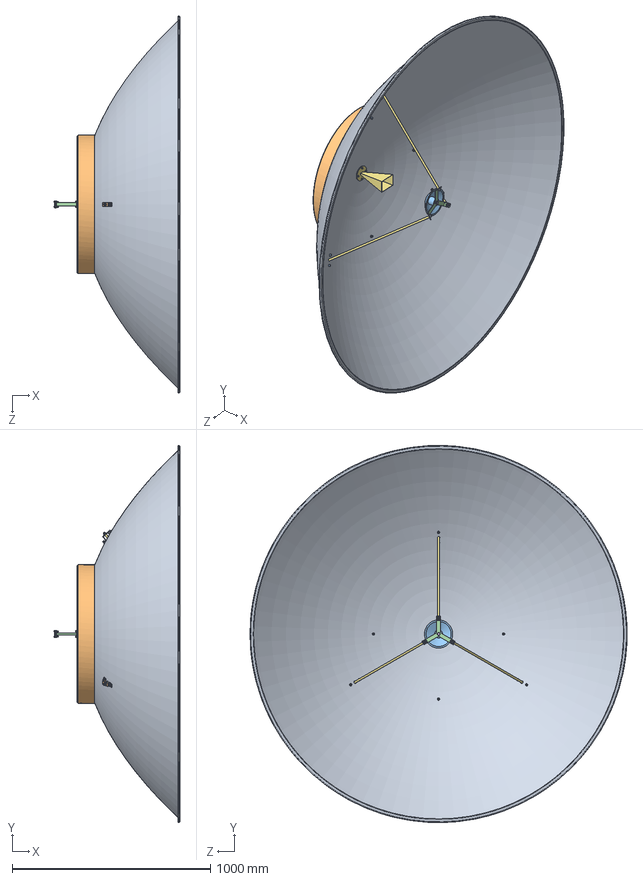
[picture p40: CAD file, 2021-09-20]
Новая папка1/КУРСАЧ2/Kursach (1)/Антенна Кассегрена.SLDASM
635.8 x 1903.6 x 1903.2 mm
Парабола
Фланец к тарелке
Малое зеркало
Крепление малого зеркала
plain washer clevis pin grade a_iso x 29
hex bolt gradeb_iso x 5
Шпильеп x 3
plain washer large grade ac_iso x 6
hex nut gradec_iso x 12
Крепление штанги к зеркалу x 3
socket head cap screw_iso x 18
Волновод
Заглушка
hex thin nut chamfered gradeab_iso x 4
Рупор
plain washer normal grade a_iso x 4
