YLexi/YL/КУРСАЧ2/Kursach (1)/Фланец к тарелке.SLDPRT

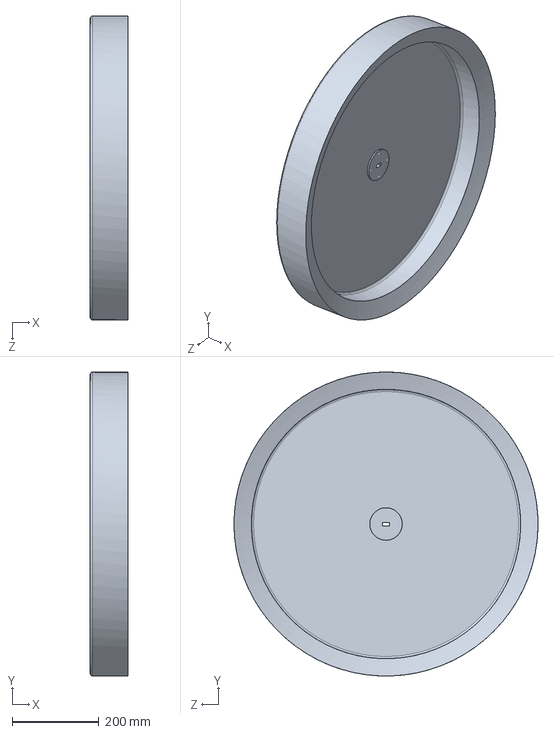
[picture p41: CAD file, 2021-09-20]
КУРСАЧ2/Kursach (1)/Фланец к тарелке.SLDPRT
86.4 x 699.9 x 699.9 mm
