YLexi/YL/КУРСАЧ2/Solid — копия/Главное зеркало.SLDPRT

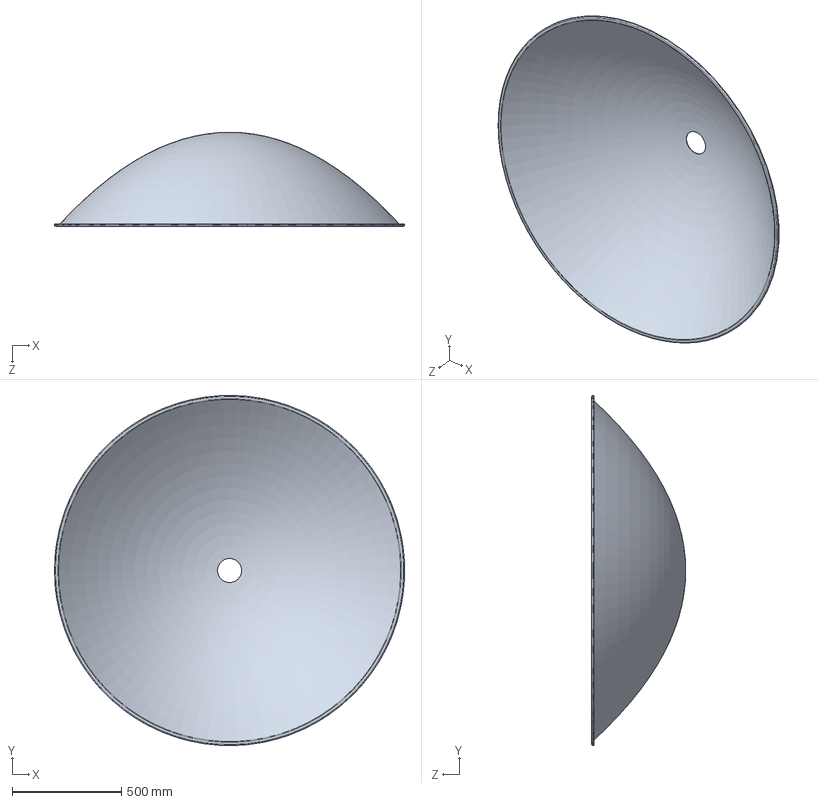
[picture p42: CAD file, 2021-09-20]
КУРСАЧ2/Solid — копия/Главное зеркало.SLDPRT
1603.3 x 1603.6 x 428.6 mm
