YLexi/YL/КУРСАЧ2/Solid/рупр.SLDPRT

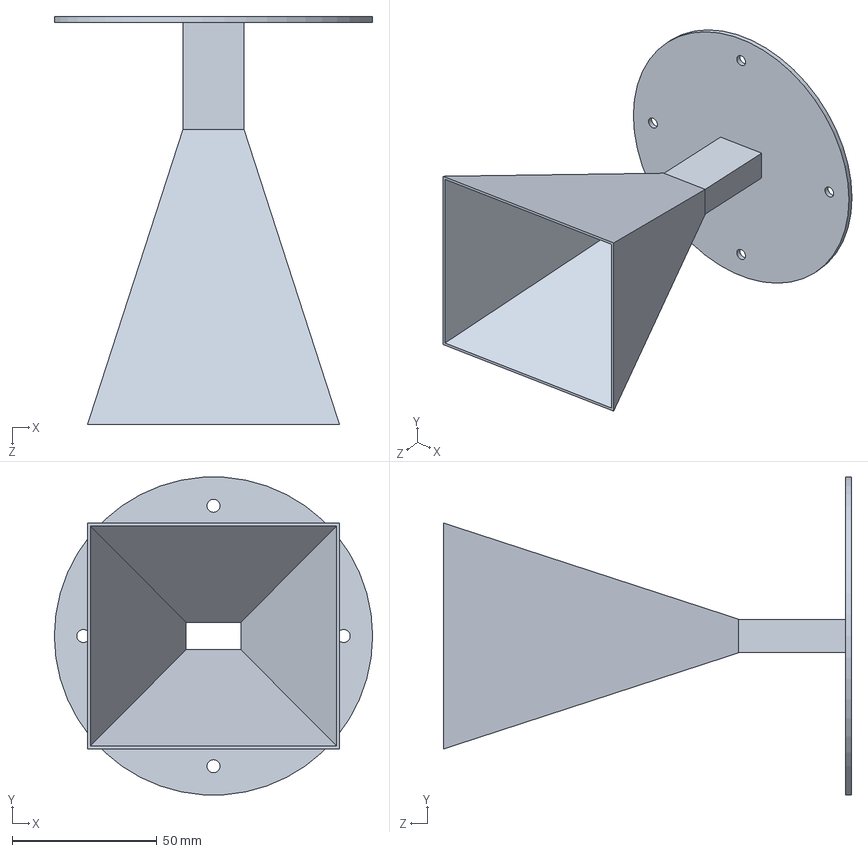
[picture p43: CAD file, 2021-09-20]
КУРСАЧ2/Solid/рупр.SLDPRT
110.0 x 109.7 x 141.0 mm
