YLexi/YL/Новая папка1/КУРСАЧ2/Kursach (1)/Рупор.SLDPRT

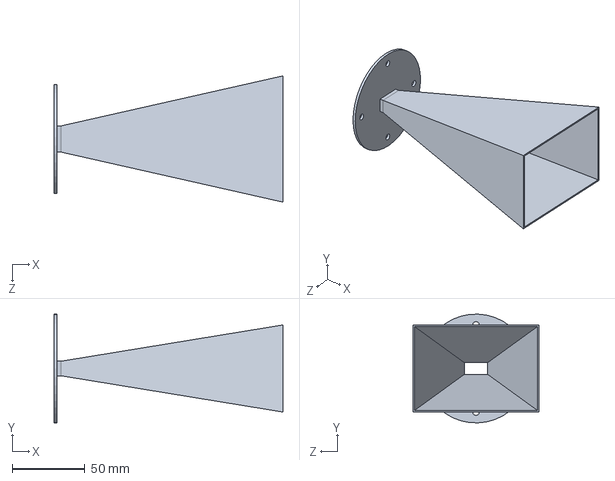
[picture p44: CAD file, 2021-09-20]
Новая папка1/КУРСАЧ2/Kursach (1)/Рупор.SLDPRT
157.8 x 74.9 x 87.0 mm
