YLexi/YL/Новая папка1/КУРСАЧ2/Solid — копия/М зеркало.SLDPRT

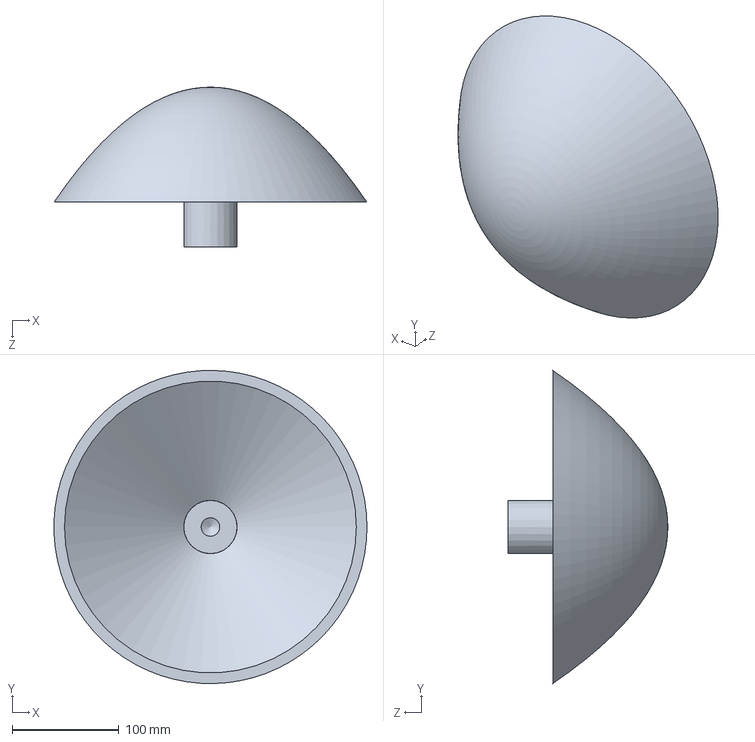
[picture p45: CAD file, 2021-09-20]
Новая папка1/КУРСАЧ2/Solid — копия/М зеркало.SLDPRT
293.9 x 293.9 x 150.0 mm
