YLexi/YL/КУРСАЧ2/Kursach (1)/Заглушка.SLDPRT

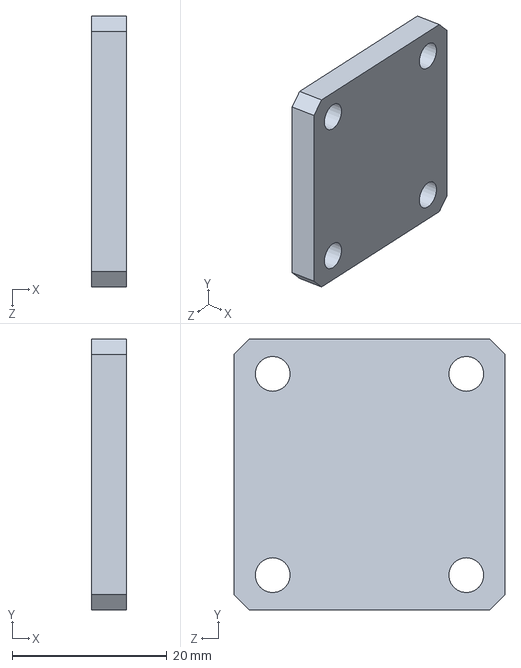
[picture p46: CAD file, 2021-09-20]
КУРСАЧ2/Kursach (1)/Заглушка.SLDPRT
4.50 x 35.0 x 35.0 mm
