YLexi/YL/КУРСАЧ2/Solid — копия/Заглyшка норм.SLDPRT

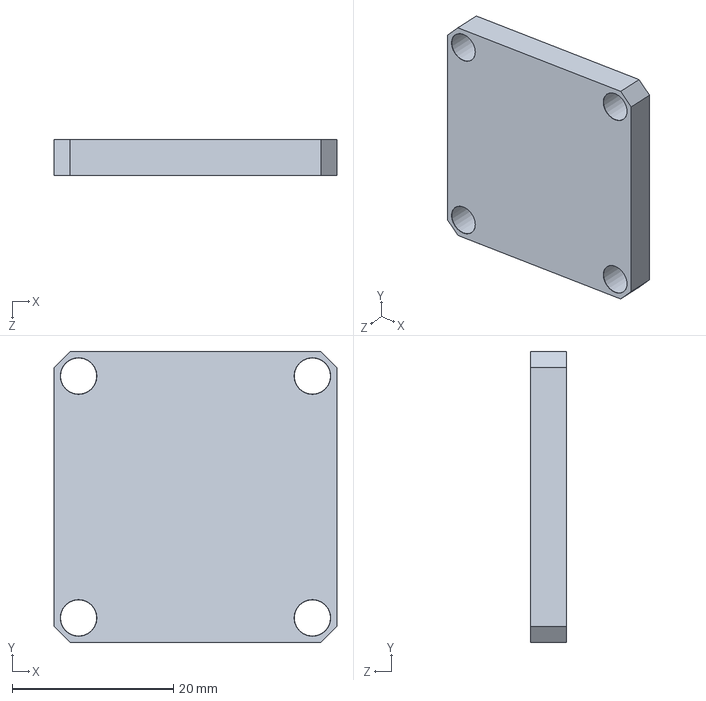
[picture p47: CAD file, 2021-09-20]
КУРСАЧ2/Solid — копия/Заглyшка норм.SLDPRT
35.1 x 36.1 x 4.50 mm
