YLexi/YL/Новая папка1/КУРСАЧ2/Solid/Шпилька.SLDPRT

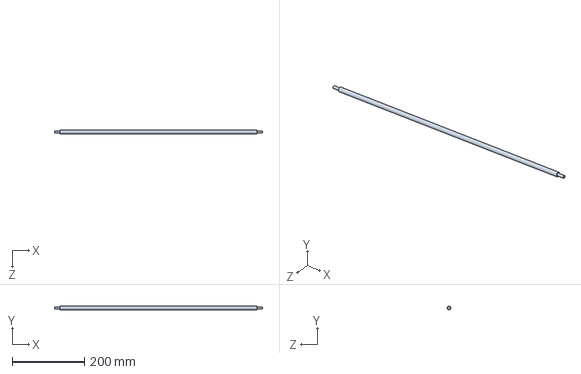
[picture p48: CAD file, 2021-09-20]
Новая папка1/КУРСАЧ2/Solid/Шпилька.SLDPRT
575.0 x 10.0 x 10.0 mm
