YLexi/YL/КУРСАЧ2/Kursach (1)/Крепление штанги к зеркалу.SLDPRT

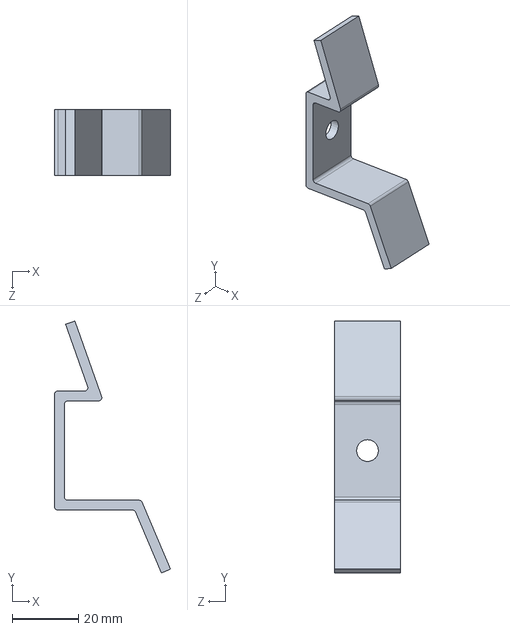
[picture p49: CAD file, 2021-09-20]
КУРСАЧ2/Kursach (1)/Крепление штанги к зеркалу.SLDPRT
35.1 x 76.2 x 20.0 mm
