YLexi/YL/Новая папка1/КУРСАЧ2/Kursach (1)/Волновод.SLDPRT

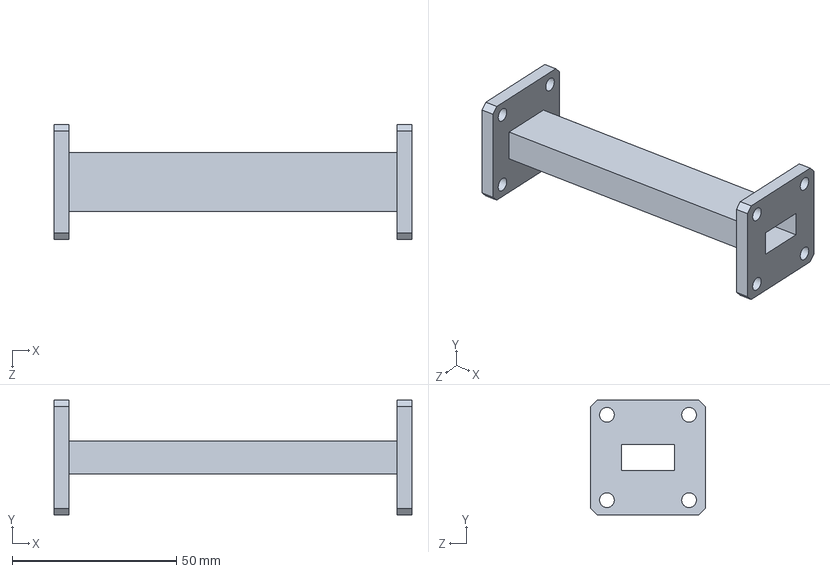
[picture p50: CAD file, 2021-09-20]
Новая папка1/КУРСАЧ2/Kursach (1)/Волновод.SLDPRT
109.0 x 35.0 x 35.0 mm
