YLexi/YL/Новая папка1/КУРСАЧ2/Solid — копия/бол фланец.SLDPRT

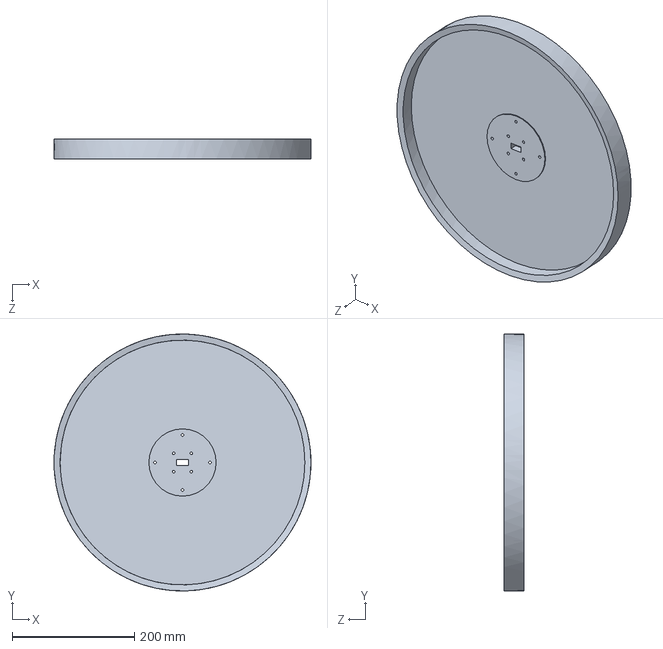
[picture p51: CAD file, 2021-09-20]
Новая папка1/КУРСАЧ2/Solid — копия/бол фланец.SLDPRT
420.0 x 419.8 x 32.0 mm
