YLexi/YL/Новая папка1/КУРСАЧ2/Solid/Фланец.SLDPRT

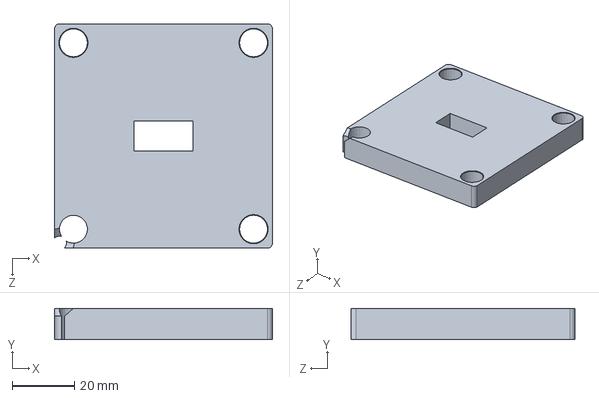
[picture p52: CAD file, 2021-09-20]
Новая папка1/КУРСАЧ2/Solid/Фланец.SLDPRT
70.2 x 10.0 x 72.2 mm
