YLexi/YL/Новая папка1/КУРСАЧ2/Solid/бол фланец.SLDPRT

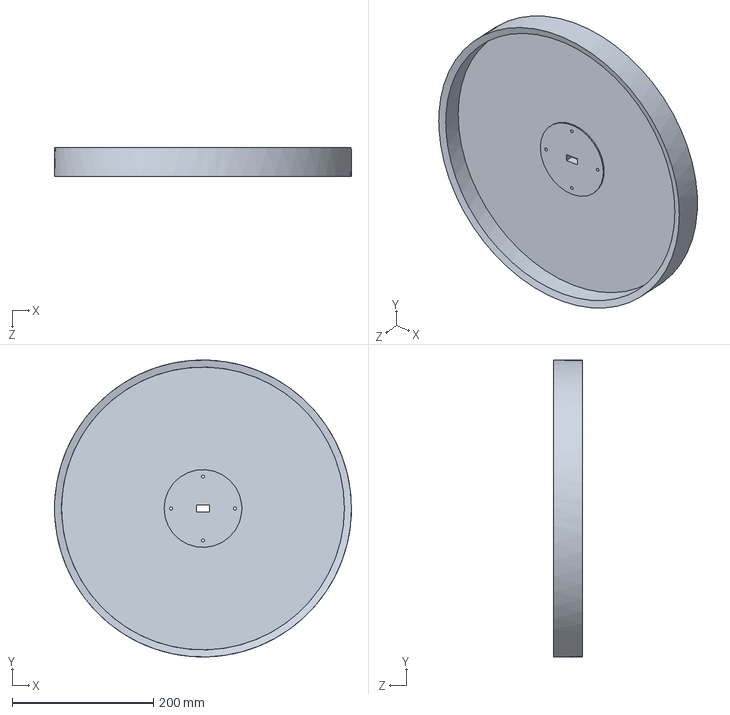
[picture p53: CAD file, 2021-09-20]
Новая папка1/КУРСАЧ2/Solid/бол фланец.SLDPRT
420.0 x 419.8 x 40.6 mm
