YLexi/YL/КУРСАЧ2/Kursach (1)/Малое зеркало.SLDPRT

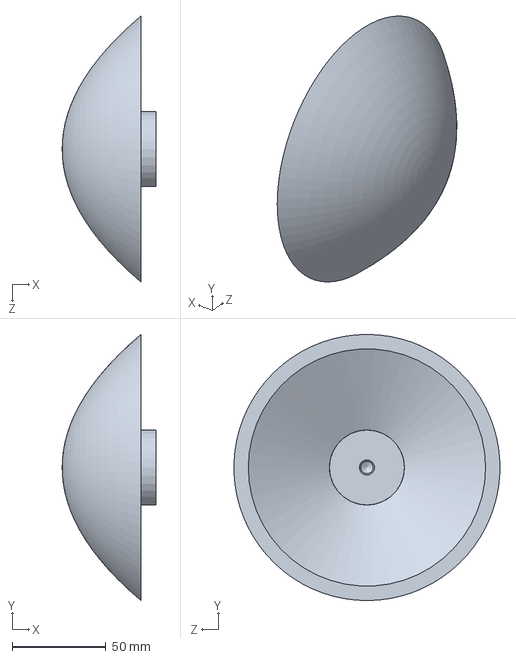
[picture p54: CAD file, 2021-09-20]
КУРСАЧ2/Kursach (1)/Малое зеркало.SLDPRT
50.0 x 142.0 x 141.9 mm
