YLexi/YL/Новая папка1/КУРСАЧ2/Solid — копия/креп м зеркала.SLDPRT

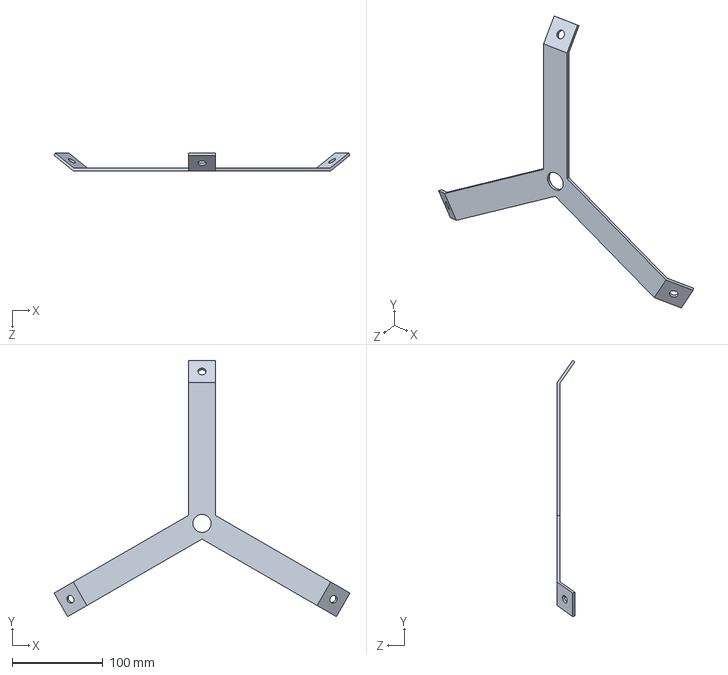
[picture p55: CAD file, 2021-09-20]
Новая папка1/КУРСАЧ2/Solid — копия/креп м зеркала.SLDPRT
326.0 x 282.4 x 19.7 mm
