YLexi/YL/КУРСАЧ2/Kursach (1)/Парабола.SLDPRT

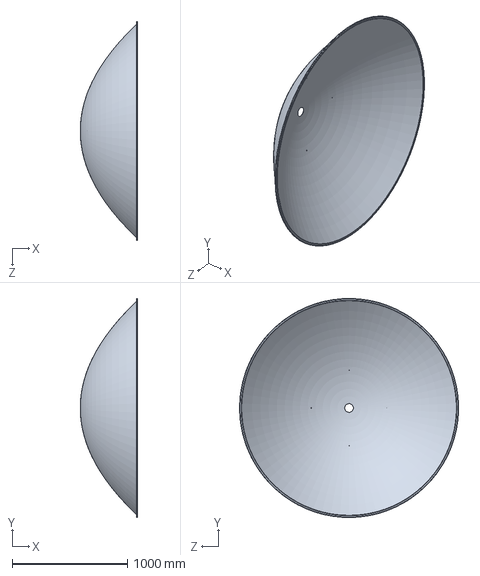
[picture p56: CAD file, 2021-09-20]
КУРСАЧ2/Kursach (1)/Парабола.SLDPRT
498.7 x 1903.6 x 1903.2 mm
