YLexi/YL/КУРСАЧ2/Solid — копия/Волнов0д.SLDPRT

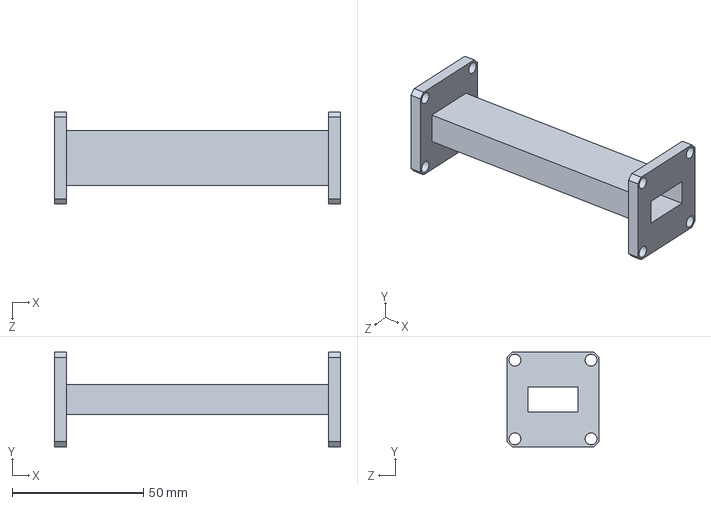
[picture p57: CAD file, 2021-09-20]
КУРСАЧ2/Solid — копия/Волнов0д.SLDPRT
109.0 x 36.1 x 35.1 mm
