YLexi/YL/Новая папка1/КУРСАЧ2/Kursach (1)/Крепление малого зеркала.SLDPRT

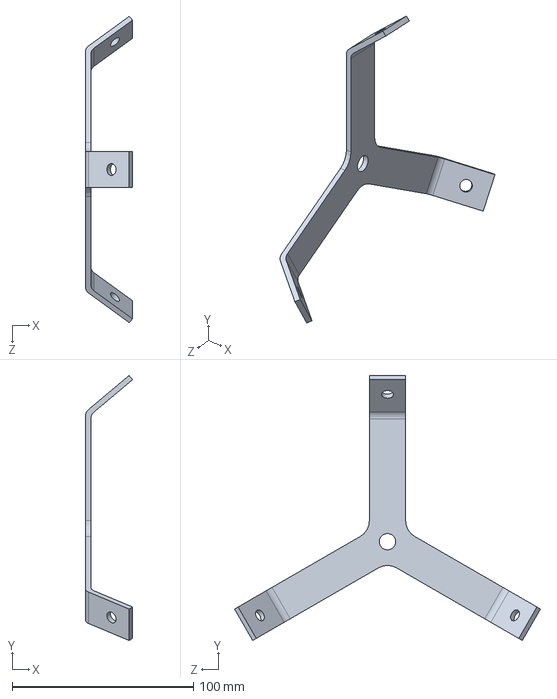
[picture p58: CAD file, 2021-09-20]
Новая папка1/КУРСАЧ2/Kursach (1)/Крепление малого зеркала.SLDPRT
26.0 x 146.0 x 168.6 mm
