YLexi/YL/(list of files, cad)

Other CAD files:
КУРСАЧ2/Solid/сборка малого зеркала.SLDASM
Новая папка1/КУРСАЧ2/Solid/сборка малого зеркала.SLDASM
Новая папка1/КУРСАЧ2/Solid/М зеркало.SLDPRT
КУРСАЧ2/Solid/М зеркало.SLDPRT
КУРСАЧ2/Solid — копия/Заглyшка.SLDPRT
КУРСАЧ2/Solid/Заглyшка норм.SLDPRT
КУРСАЧ2/Solid — копия/рупр.SLDPRT
КУРСАЧ2/Solid/Крепление штанги.SLDPRT
Новая папка1/КУРСАЧ2/Solid/Заглyшка норм.SLDPRT
КУРСАЧ2/Solid — копия/Крепление штанги.SLDPRT
КУРСАЧ2/Solid/Заглyшка.SLDPRT
Новая папка1/КУРСАЧ2/Kursach (1)/Шпильеп.SLDPRT
Новая папка1/КУРСАЧ2/Solid — копия/Шпилька.SLDPRT
Новая папка1/КУРСАЧ2/Solid/Крепление штанги.SLDPRT
Новая папка1/КУРСАЧ2/Solid/Волнов0д.SLDPRT
КУРСАЧ2/Solid/Главное зеркало.SLDPRT
Новая папка1/КУРСАЧ2/Solid — копия/Заглyшка.SLDPRT
Новая папка1/КУРСАЧ2/Solid/Главное зеркало.SLDPRT
КУРСАЧ2/Kursach (1)/Шпильеп.SLDPRT
Новая папка1/КУРСАЧ2/Solid — копия/рупр.SLDPRT
КУРСАЧ2/Solid/креп м зеркала.SLDPRT
КУРСАЧ2/Solid — копия/Шпилька.SLDPRT
КУРСАЧ2/Solid/Волнов0д.SLDPRT
Новая папка1/КУРСАЧ2/Solid/креп м зеркала.SLDPRT
Новая папка1/КУРСАЧ2/Solid — копия/Крепление штанги.SLDPRT
Новая папка1/КУРСАЧ2/Solid/Заглyшка.SLDPRT
КУРСАЧ2/Спецификация.SLDDRW
КУРСАЧ2/Чертежы/Антенна Кассегрена.SLDDRW
КУРСАЧ2/Чертежы/Сборочный чертеж.SLDDRW
КУРСАЧ2/Чертежы/большой фланец.SLDDRW
КУРСАЧ2/Чертежы/сборка малого зеркала.SLDDRW
Новая папка1/КУРСАЧ2/Спецификация.SLDDRW
Новая папка1/КУРСАЧ2/Чертежы/Антенна Кассегрена.SLDDRW
Новая папка1/КУРСАЧ2/Чертежы/Сборочный чертеж.SLDDRW
Новая папка1/КУРСАЧ2/Чертежы/большой фланец.SLDDRW
Новая папка1/КУРСАЧ2/Чертежы/сборка малого зеркала.SLDDRW
