YLexi/YL/КУРСАЧ2/Спецификация.PDF

Документация

| МГТУ.464655.000 ВО | Чертеж общего вида
А2 | МГТУ.464655.000 СБ | Сборочный чертеж

Сборочные единицы

А3 | 1 | МГТУ.464655.001 СБ | Малое зеркало | 1
| 9 МГТУ.468573.009 | | Рупор | 1

Детали

| 2 МГТУ.468581.002 | | Большое зеркало | 1
| 3 | МГТУ.468589.003 | Крепление штанги | 3
А3 | 4 МГТУ.468589.004 | | Штанга | 3
| 5 | МГТУ.468559.005 | Фланец большого зеркала | 1
| 6 МГТУ.468554.006 | | Фланец волноводный | 3
| 7 МГТУ.468541.007 | | Волновод | 2
| 8 МГТУ.468559.008 | | Крышка волновода | 1

Стандартные изделия

10 | ISO 4762 M4x16 - 16N | 6 | Винт
11 | ISO - 4032 - M3 - W - N | 6 | Гайка
12 | Washer ISO 7089 - 3 | 6 | Шайба
13 | ISO 4762 M3x6 - 6N | 4 | Винт
14 | ISO 4762 M4x16 - 16N | 12 | Винт

# МГТУ.464655.000

МГТУ им. Н.Э. Баумана
Кафедра РЛ1
Группа РЛ1-61

Инв. № подл. Подп. и дата Взам. инв. № Инв. № дубл. Подп. и дата Перв. примен. Справ. №

Формат А4

Копировал

Изм. | Лист | № докум. | Подп. | Дата
| | Разраб. | Чекановский С.А. | | Антенна Кассегрена | Лит. | Лист | Листов
Пров. | Вечтомов В.А. | | | | | | 1 | 2

Н. контр.
Утв.

Файл: Спецификация

Формат
Зона
Поз.
Обозначение | Наименование
Кол.

Примечание

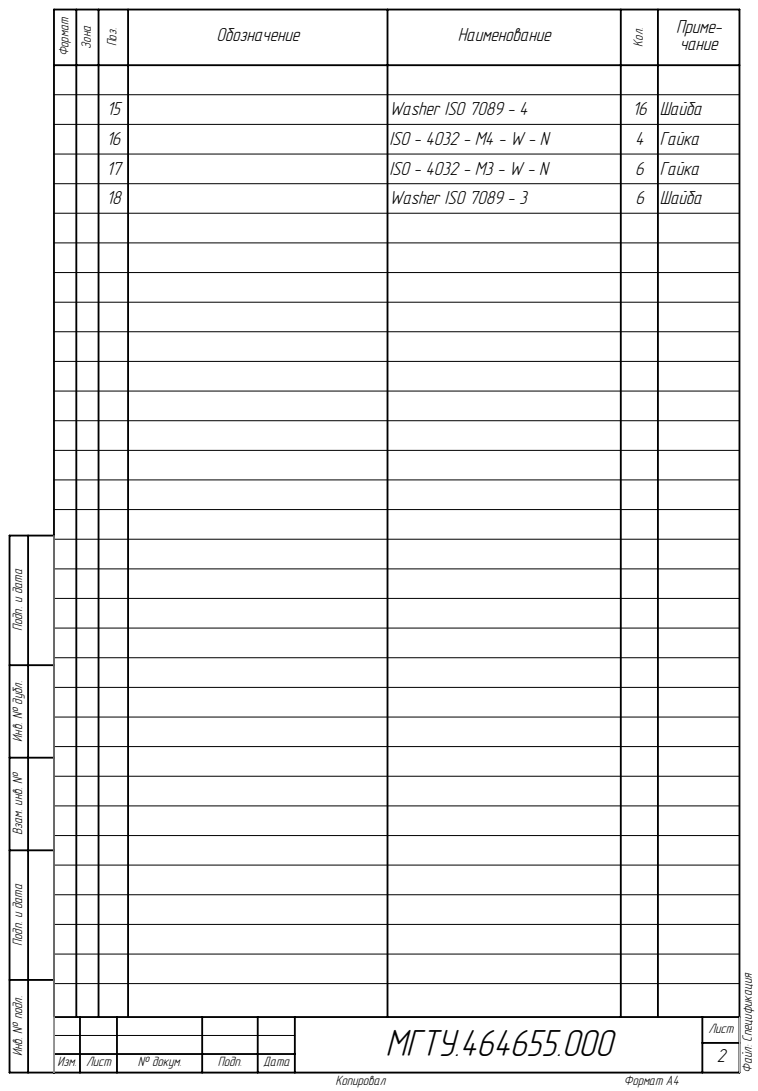
[picture p59: page 2]
Инв. № подл.; Копировал; Формат А4; Изм.; Лист; № докум.; Подп.; Дата; Файл: Спецификация; чание Обозначение; Наименование

15 | Washer ISO 7089 - 4 | 16 | Шайба
16 | ISO - 4032 - M4 - W - N | 4 | Гайка
17 | ISO - 4032 - M3 - W - N | 6 | Гайка
18 | Washer ISO 7089 - 3 | 6 | Шайба

Подп. и дата Взам. инв. № Инв. № дубл. Подп. и дата
