YLexi/YL/КУРСАЧ2/ПЕЧАТЬ/Антенна Кассегрена.pdf

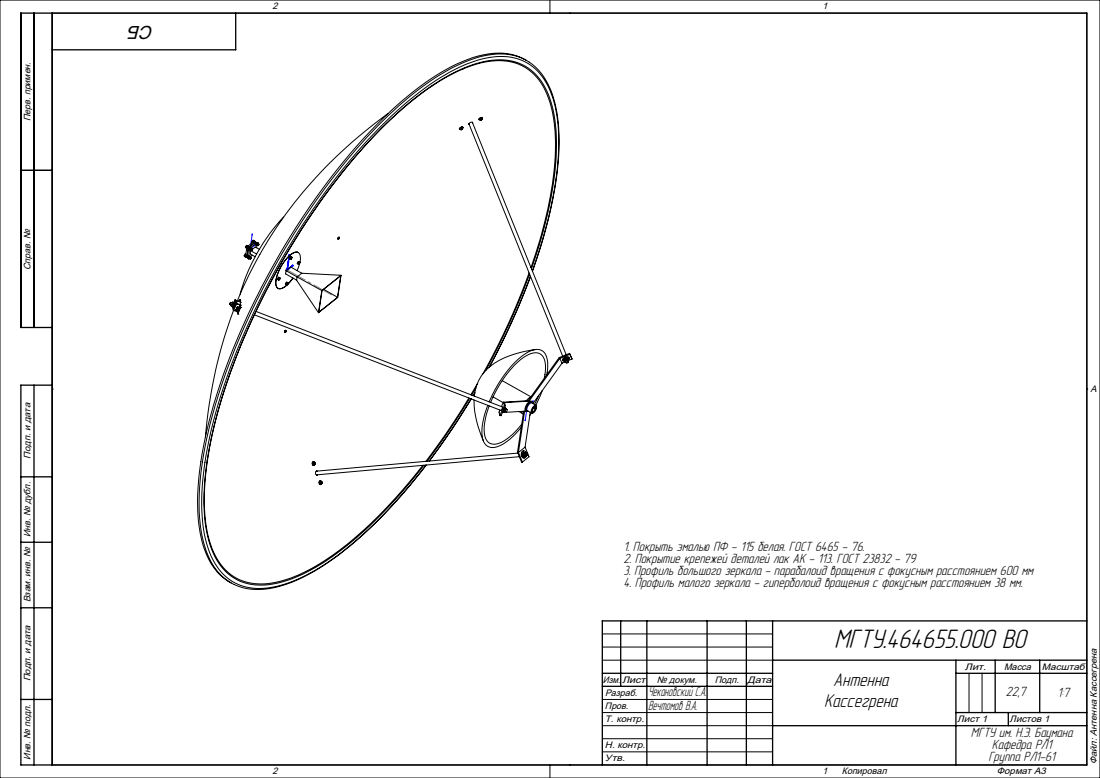
[picture p60: page 1]
Копировал; Формат А3

Справ. № Перв. примен. Подп. и дата Инв. № дубл. Взам. инв. № Подп. и дата Инв. № подл.

1. Ïîêðûòü ýìàëüþ ÏÔ - 115 áåëàÿ. ÃÎÑÒ 6465 - 76.
2. Ïîêðûòèå êðåïåæåé äåòàëåé ëàê ÀÊ - 113. ÃÎÑÒ 23832 - 79
3. Ïðîôèëü áîëüøîãî çåðêàëà - ïàðàáàëîèä âðàùåíèÿ ñ ôîêóñíûì ðàññòîÿíèåì 600 ìì
4. Ïðîôèëü ìàëîãî çåðêàëà - ãèïåðáîëîèä âðàùåíèÿ ñ ôîêóñíûì ðàññòîÿíèåì 38 ìì.

ÌÃÒÓ.464655.000 ÂÎ
Àíòåííà Êàññåãðåíà | Лит. | Масса | Масштаб

Файл: Антенна Кассегрена

Изм. | Лист № докум. | | Подп. | Дата | | | | | 22,7 | 1:7
Разраб. | | ×åêàíîâñêèé Ñ.À.
Пров. | | Âå÷òîìîâ Â.À.
Т. контр. | | | | | Лист 1 | Листов 1

ÌÃÒÓ èì. Í.Ý. Áàóìàíà Êàôåäðà ÐË1 Ãðóïïà ÐË1-61

Н. контр.
Утв.
