YLexi/YL/КУРСАЧ2/ПЕЧАТЬ/большой фланец.PDF

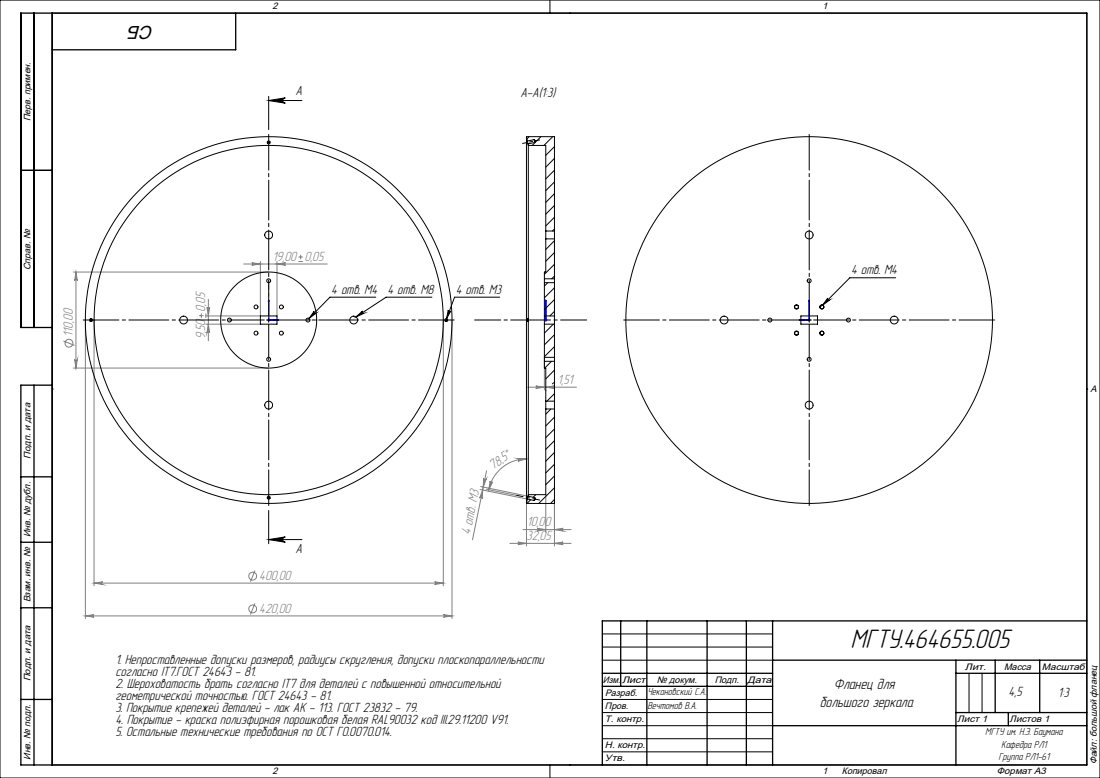
[picture p61: page 1]
4 îòâ. Ì4 4 îòâ. Ì8; 4 îòâ. Ì3; 4 îòâ. Ì4; Копировал; Формат А3

Справ. № Перв. примен. Подп. и дата Инв. № дубл. Взам. инв. № Подп. и дата Инв. № подл.

ÌÃÒÓ.464655.005

1. Íåïðîñòàâëåííûå äîïóñêè ðàçìåðîâ, ðàäèóñû ñêðóãëåíèÿ, äîïóñêè ïëîñêîïàðàëëåëüíîñòè
ñîãëàñíî IT7.ÃÎÑÒ 24643 - 81.
2. Øåðîõîâàòîñòü áðàòü ñîãëàñíî IT7 äëÿ äåòàëåé ñ ïîâûøåííîé îòíîñèòåëüíîé
ãåîìåòðè÷åñêîé òî÷íîñòüþ. ÃÎÑÒ 24643 - 81.
3. Ïîêðûòèå êðåïåæåé äåòàëåé - ëàê ÀÊ - 113. ÃÎÑÒ 23832 - 79.
4. Ïîêðûòèå - êðàñêà ïîëèýôèðíàÿ ïîðîøêîâàÿ áåëàÿ RAL90032 êîä III.29.11200 V91.
5. Îñòàëüíûå òåõíè÷åñêèå òðåáîâàíèÿ ïî ÎÑÒ ÃÎ.0070.014.

Ôëàíåö äëÿ áîëüøîãî çåðêàëà | Лит. | Масса | Масштаб

Файл: большой фланец

Изм. | Лист № докум. | | Подп. | Дата | | | | | 4,5 | 1:3
Разраб. | | ×åêàíîâñêèé Ñ.À.
Пров. | | Âå÷òîìîâ Â.À.
Т. контр. | | | | | Лист 1 | Листов 1

ÌÃÒÓ èì. Í.Ý. Áàóìàíà Êàôåäðà ÐË1 Ãðóïïà ÐË1-61

Н. контр.
Утв.
