YLexi/YL/КУРСАЧ2/ПЕЧАТЬ/сборка малого зеркала.PDF

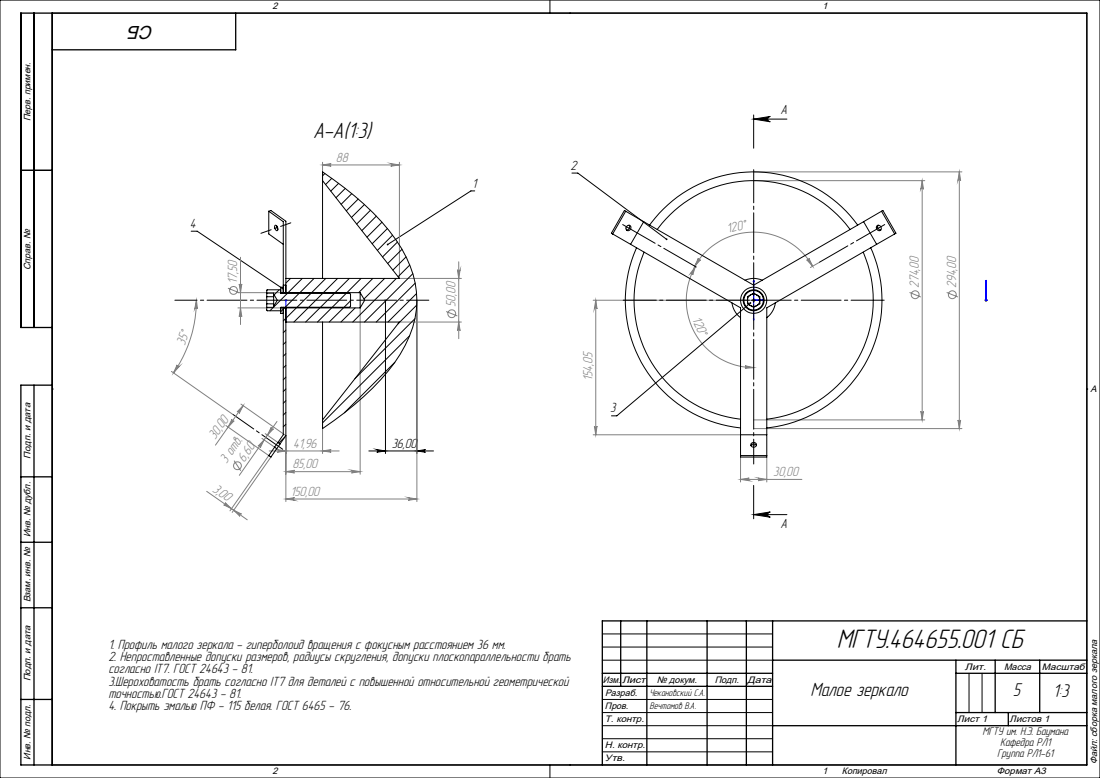
[picture p62: page 1]
3 îòâ.; Копировал; Формат А3

Справ. № Перв. примен. Подп. и дата Инв. № дубл. Взам. инв. № Подп. и дата Инв. № подл.

ÌÃÒÓ.464655.001 ÑÁ
Ìàëîå çåðêàëî | Лит. | Масса | Масштаб

1. Ïðîôèëü ìàëîãî çåðêàëà - ãèïåðáîëîèä âðàùåíèÿ ñ ôîêóñíûì ðàññòîÿíèåì 36 ìì.
2. Íåïðîñòàâëåííûå äîïóñêè ðàçìåðîâ, ðàäèóñû ñêðóãëåíèÿ, äîïóñêè ïëîñêîïàðàëëåëüíîñòè áðàòü
ñîãëàñíî IT7. ÃÎÑÒ 24643 - 81.
3.Øåðîõîâàòîñòü áðàòü ñîãëàñíî IT7 äëÿ äåòàëåé ñ ïîâûøåííîé îòíîñèòåëüíîé ãåîìåòðè÷åñêîé
òî÷íîñòüþ.ÃÎÑÒ 24643 - 81.
4. Ïîêðûòü ýìàëüþ ÏÔ - 115 áåëàÿ. ÃÎÑÒ 6465 - 76.

Файл: сборка малого зеркала

Изм. | Лист № докум. | | Подп. | Дата | | | | | 5 | 1:3
Разраб. | | ×åêàíîâñêèé Ñ.À.
Пров. | | Âå÷òîìîâ Â.À.
Т. контр. | | | | | Лист 1 | Листов 1

ÌÃÒÓ èì. Í.Ý. Áàóìàíà Êàôåäðà ÐË1 Ãðóïïà ÐË1-61

Н. контр.
Утв.
