YLexi/YL/КУРСАЧ2/ПЕЧАТЬ/Сборочный чертеж.PDF

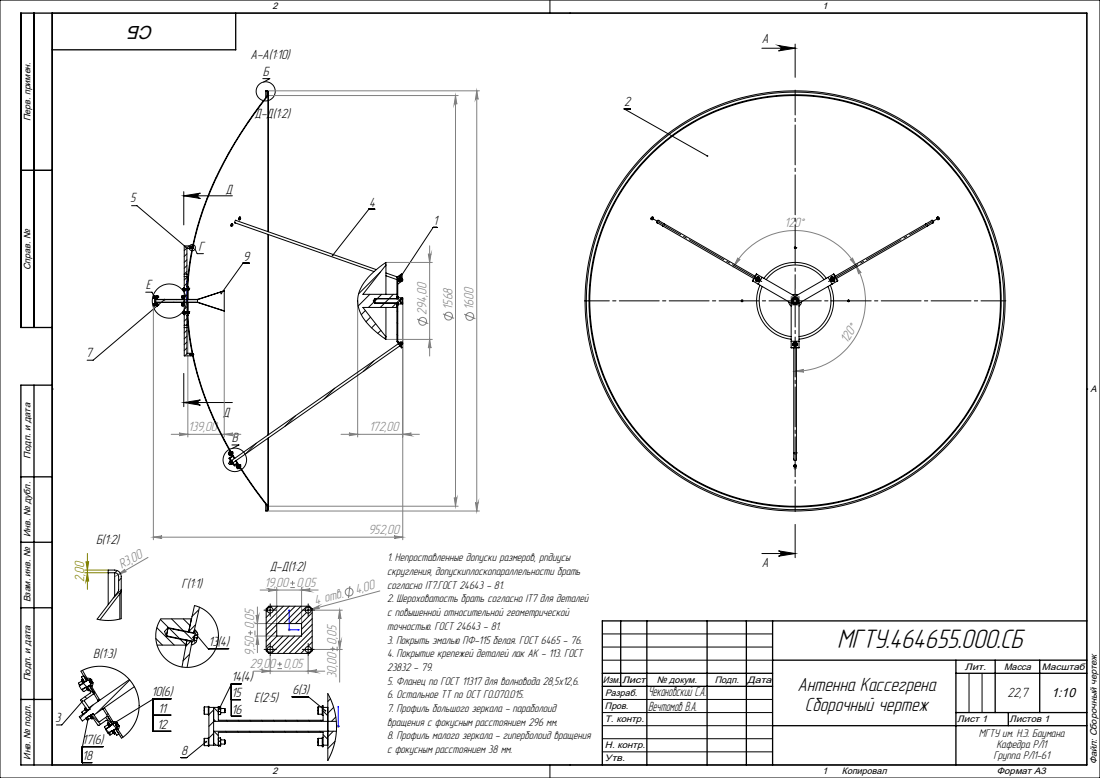
[picture p63: page 1]
ñ ôîêóñíûì ðàññòîÿíèåì 38 ìì. 294,00; 4 îòâ. 4,00; Копировал; Формат А3

Справ. № Перв. примен. Подп. и дата Инв. № дубл. Взам. инв. № Подп. и дата Инв. № подл.

1. Íåïðîñòàâëåííûå äîïóñêè ðàçìåðîâ, ðïäèóñû
ñêðóãëåíèÿ, äîïóñêèïëîñêîïàðàëëåëüíîñòè áðàòü
ñîãëàñíî IT7.ÃÎÑÒ 24643 - 81.
2. Øåðîõîâàòîñòü áðàòü ñîãëàñíî IT7 äëÿ äåòàëåé
ñ ïîâûøåííîé îòíîñèòåëüíîé ãåîìåòðè÷åñêîé
òî÷íîñòüþ. ÃÎÑÒ 24643 - 81.
3. Ïîêðûòü ýìàëüþ ÏÔ-115 áåëàÿ. ÃÎÑÒ 6465 - 76.
4. Ïîêðûòèå êðåïåæåé äåòàëåé ëàê ÀÊ - 113. ÃÎÑÒ
5. Ôëàíåö ïî ÃÎÑÒ 11317 äëÿ âîëíîâîäà 28,5õ12,6.
6. Îñòàëüíîå ÒÒ ïî ÎÑÒ ÃÎ.070.015.
7. Ïðîôèëü áîëüøîãî çåðêàëà - ïàðàáîëîèä
âðàùåíèÿ ñ ôîêóñíûì ðàññòîÿíèåì 296 ìì.
8. Ïðîôèëü ìàëîãî çåðêàëà - ãèïåðáîëîèä âðàùåíèÿ

ÌÃÒÓ.464655.000.ÑÁ
Àíòåííà Êàññåãðåíà Ñáîðî÷íûé ÷åðòåæ | Лит. | Масса | Масштаб

Файл: Сборочный чертеж

Изм. | Лист № докум. | | Подп. | Дата | | | | | 22,7 | 1:10
Разраб. | | ×åêàíîâñêèé Ñ.À.
Пров. | | Âå÷òîìîâ Â.À.
Т. контр. | | | | | Лист 1 | Листов 1

ÌÃÒÓ èì. Í.Ý. Áàóìàíà Êàôåäðà ÐË1 Ãðóïïà ÐË1-61

Н. контр.
Утв.
